ska-sa/roach2_chassis_design/Notes/ROACH 2 Thermal Analaysis/ROACH 2 Chassis Thermal Report Idle/ROACH_2_Idle_10k.bmp

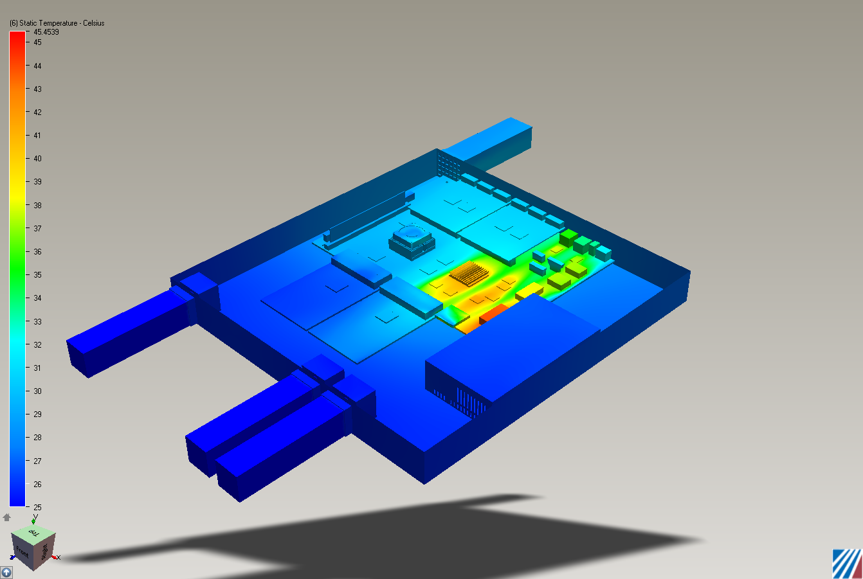
Notes/ROACH 2 Thermal Analaysis/ROACH 2 Chassis Thermal Report Idle/ROACH_2_Idle_10k.bmp
