ska-sa/roach2_chassis_design/Pro-Engineer_Files/ROACH_2_Chassis_SMA/roach_2_assembly.jpg

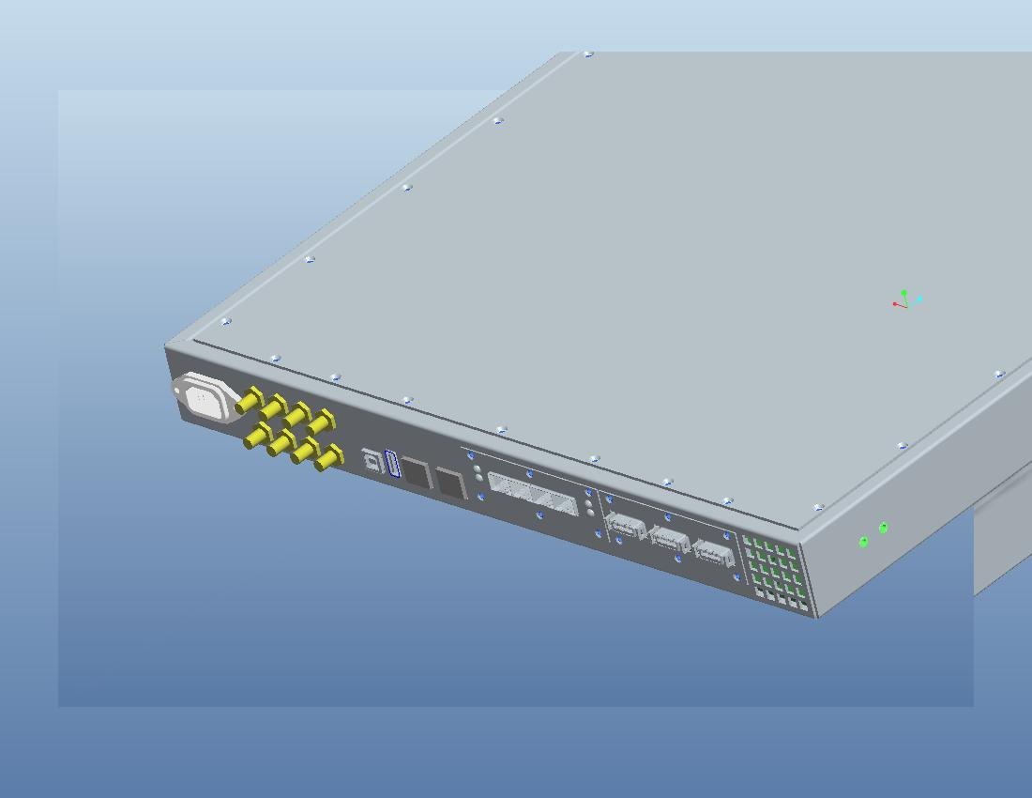
Pro-Engineer_Files/ROACH_2_Chassis_SMA/roach_2_assembly.jpg
