ska-sa/roach2_chassis_design/README.txt

Files in this repo:
CFD_Models - simplified 3d CAD files for thermal analaysis
Notes - documentation requested at various times
Pro-Engineeer_Files - 3d CAD files used in Pro-Engineer/Creo
roach_2_manufacture - 3d CAD (in .stp), pdf etc required for manufacturing the chassis
