ska-sa/roach2_chassis_design/Notes/ROACH 2 Thermal Analaysis/ROACH 2 Chassis Thermal Report Normal Run/FPGA_20W.bmp

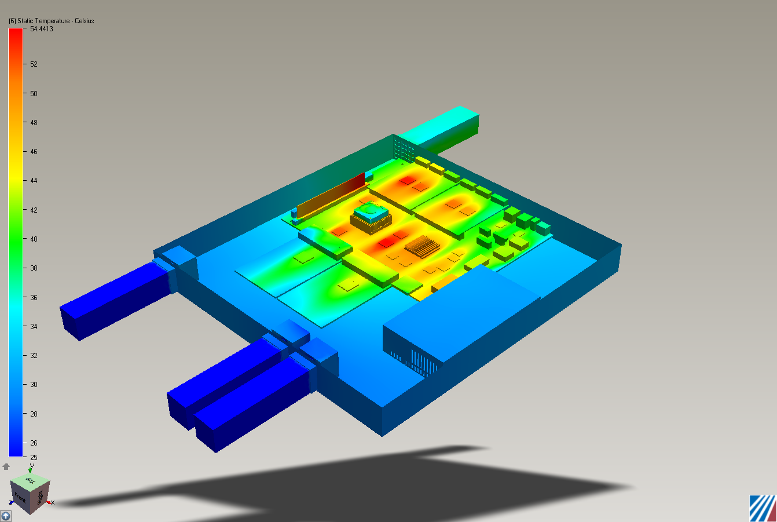
Notes/ROACH 2 Thermal Analaysis/ROACH 2 Chassis Thermal Report Normal Run/FPGA_20W.bmp
