ska-sa/roach2_chassis_design/Pro-Engineer_Files/kat_adc_2012/adc1x2200-10_v1-1.jpg

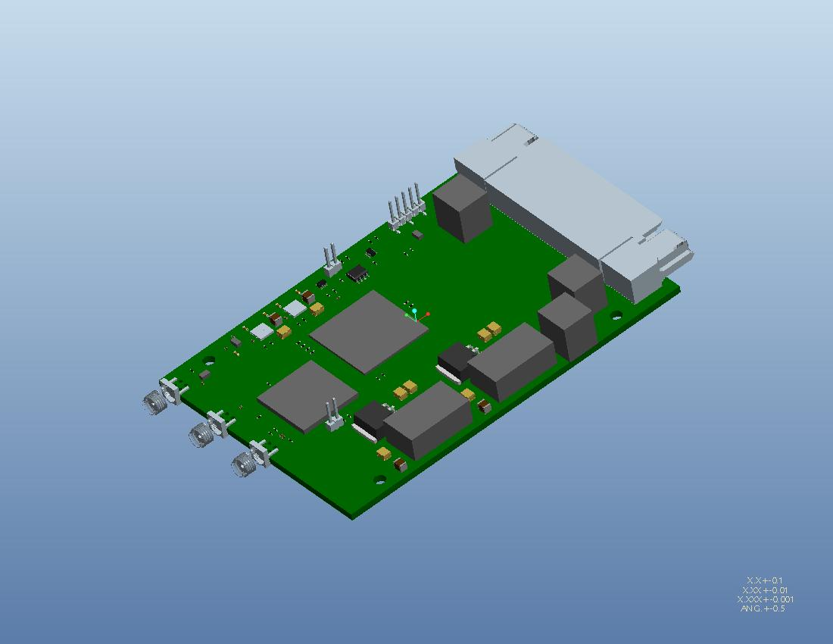
Pro-Engineer_Files/kat_adc_2012/adc1x2200-10_v1-1.jpg
