ska-sa/roach2_chassis_design/Pro-Engineer_Files/ROACH_2_Chassis/roach_2_chassis_iso.tif

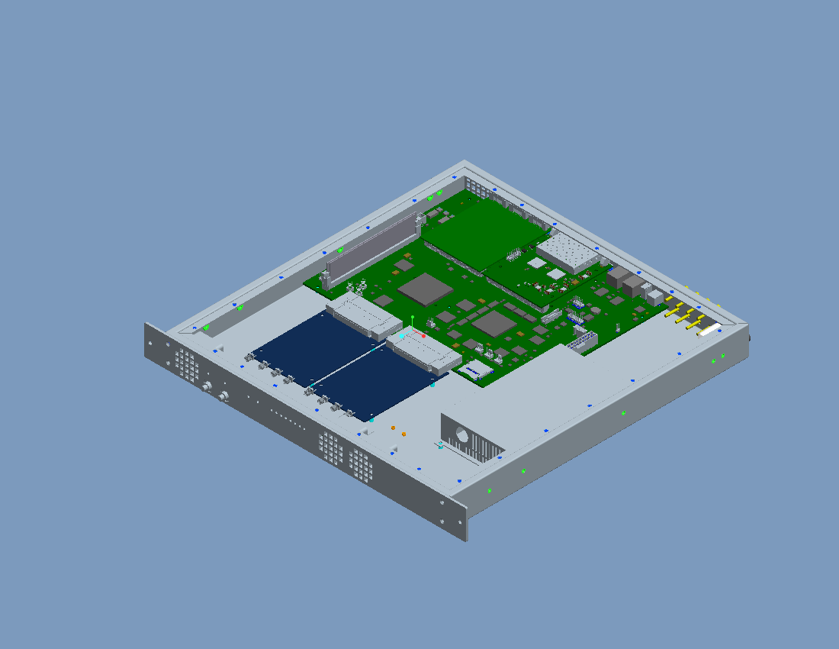
Pro-Engineer_Files/ROACH_2_Chassis/roach_2_chassis_iso.tif
