ska-sa/roach2_chassis_design/Thermal_Pics/DC_0255.jpg

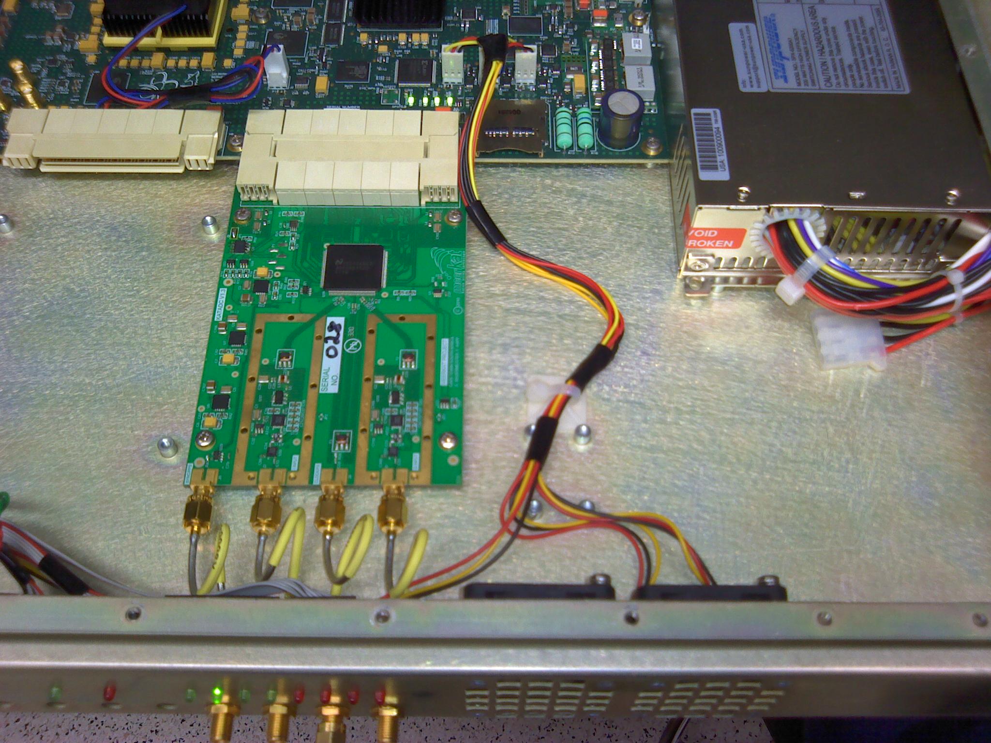
Thermal_Pics/DC_0255.jpg
