ska-sa/roach2_chassis_design/Thermal_Pics/DC_0261.jpg

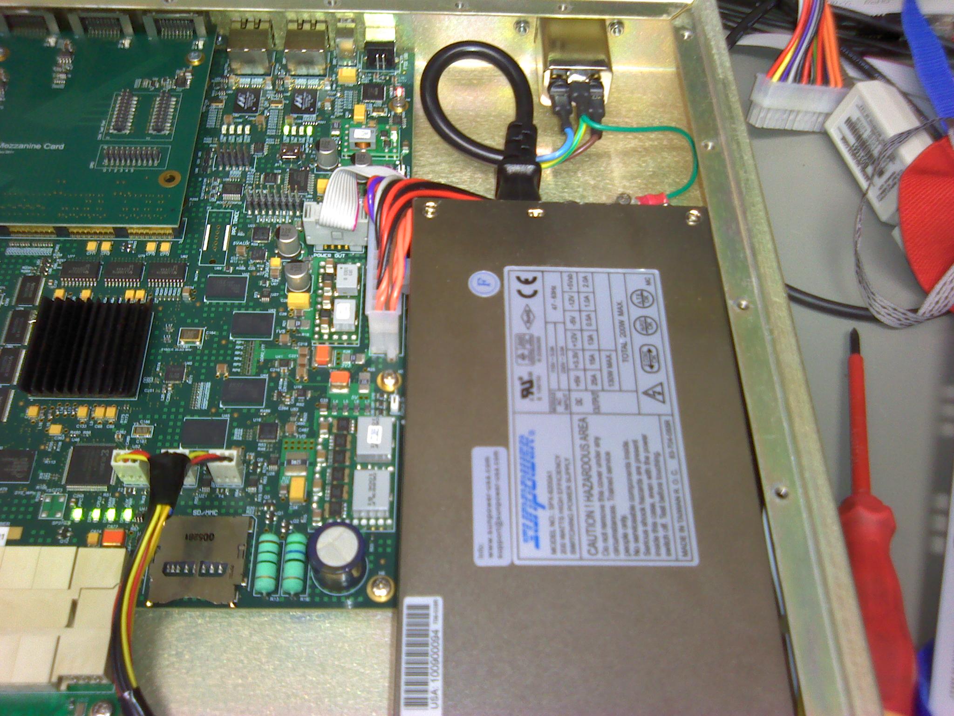
Thermal_Pics/DC_0261.jpg
