ska-sa/roach2_chassis_design/Thermal_Pics/DC_0293.jpg

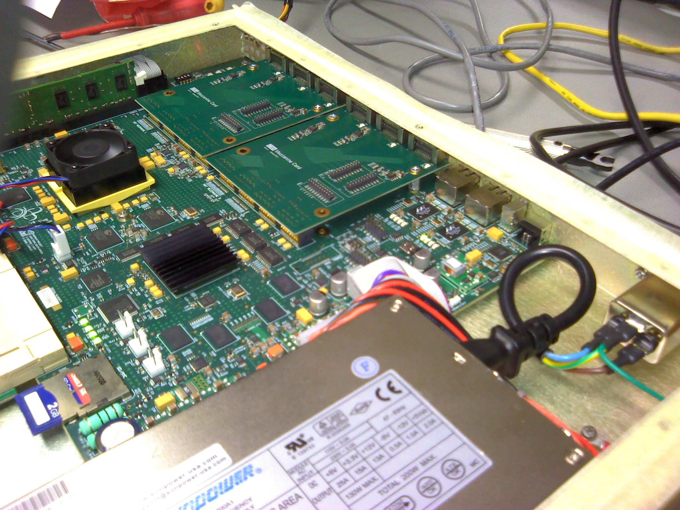
Thermal_Pics/DC_0293.jpg
