ska-sa/roach2_chassis_design/Thermal_Pics/IR_0256.jpg

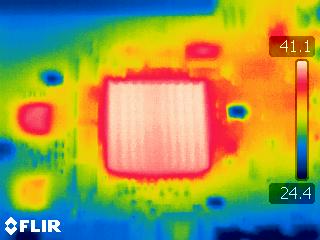
Thermal_Pics/IR_0256.jpg
