ska-sa/roach2_chassis_design/Thermal_Pics/IR_0260.jpg

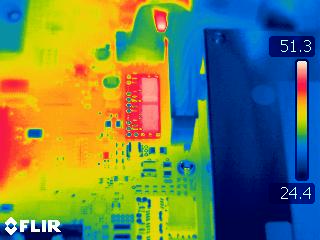
Thermal_Pics/IR_0260.jpg
