ska-sa/roach2_chassis_design/Thermal_Pics/IR_0272.jpg

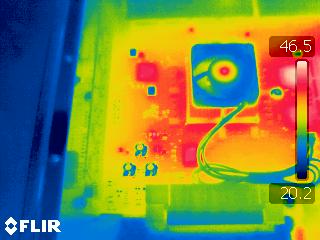
Thermal_Pics/IR_0272.jpg
