ska-sa/roach2_chassis_design/Thermal_Pics/IR_0278.jpg

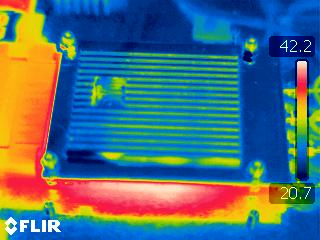
Thermal_Pics/IR_0278.jpg
