ska-sa/roach2_chassis_design/CFD_Models/ROACH_2_CFD_5.2_AllFab_L_Out/adc_new/new_adc.stp

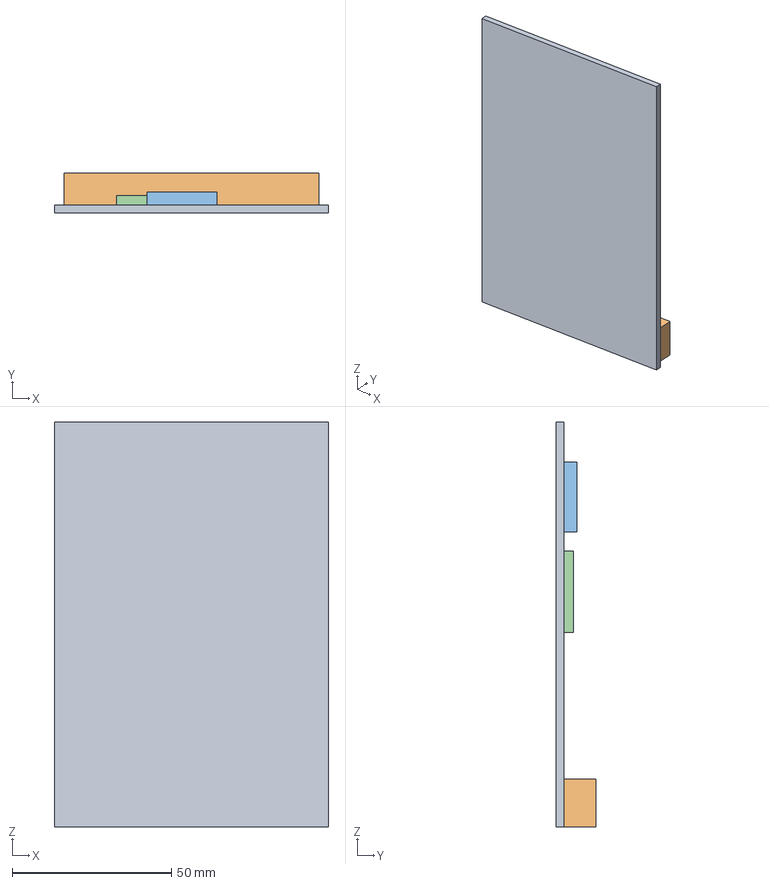
[picture p56: CAD file, 2013-02-20]
CFD_Models/ROACH_2_CFD_5.2_AllFab_L_Out/adc_new/new_adc.stp
86.0 x 12.5 x 127.0 mm
ADC_PCB
ADC_CONNECTOR
ADC_CHIP_NEW
DMUX
