ska-sa/roach2_chassis_design/Pro-Engineer_Files/Current_ROACH_2_Chassis/roach-2-chassis-back.dxf

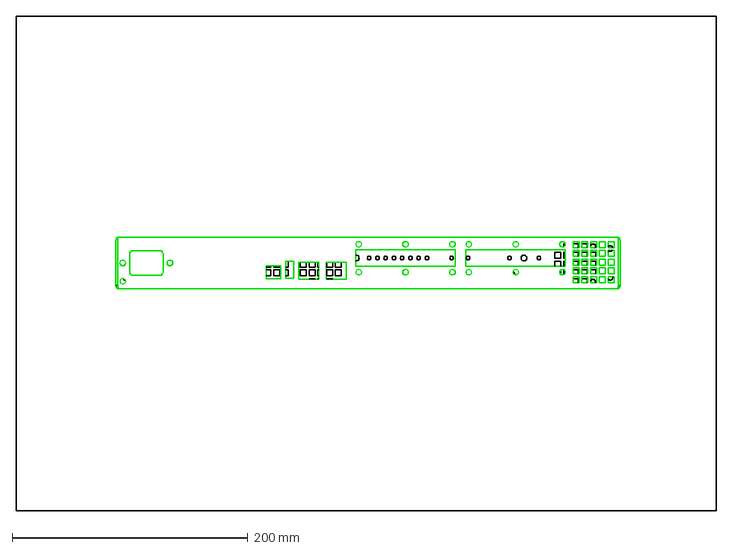
[picture p57: CAD file, 2014-04-12]
Pro-Engineer_Files/Current_ROACH_2_Chassis/roach-2-chassis-back.dxf
594.0 x 420.0 mm
