ska-sa/roach2_chassis_design/Pro-Engineer_Files/ROACH_2_Chassis/ROACH_PCB/User Library-ddr3 dimm sdram.STEP

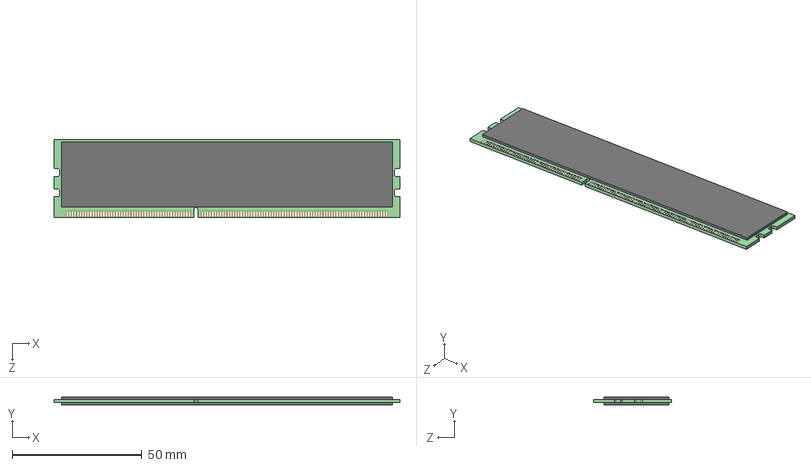
[picture p58: CAD file, 2013-05-10]
Pro-Engineer_Files/ROACH_2_Chassis/ROACH_PCB/User Library-ddr3 dimm sdram.STEP
133.3 x 3.27 x 30.0 mm
