ska-sa/roach2_chassis_design/Pro-Engineer_Files/ROACH_2_Chassis_SMA/roach-2-chassis-manufacturer_bpanel.dxf

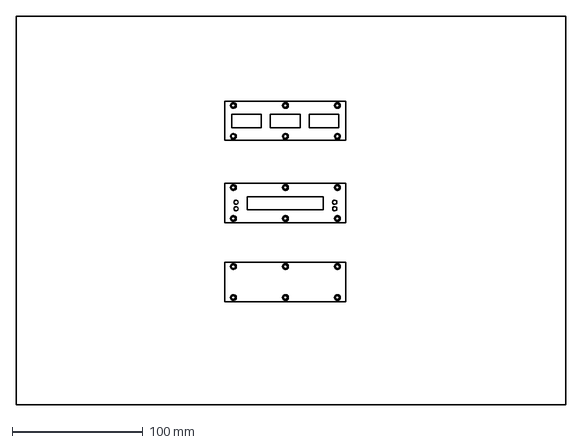
[picture p60: CAD file, 2012-06-26]
Pro-Engineer_Files/ROACH_2_Chassis_SMA/roach-2-chassis-manufacturer_bpanel.dxf
420.0 x 297.0 mm
