ska-sa/roach2_chassis_design/roach_2_manufacture/dxf/roach-2-chassis-flat.dxf

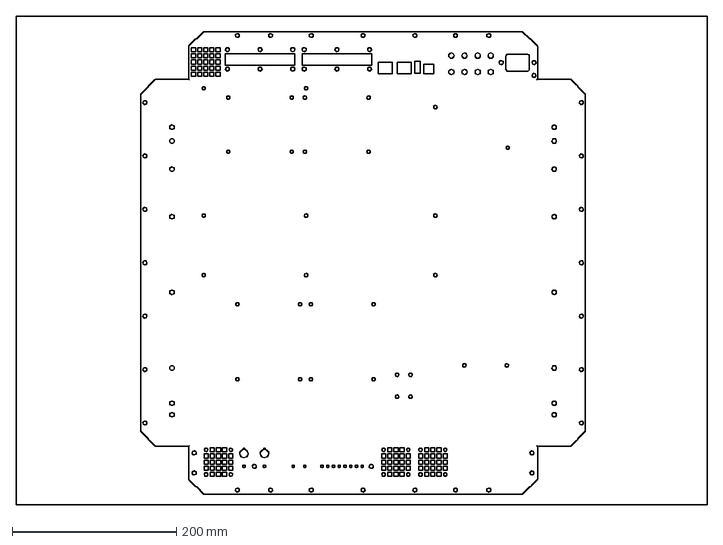
[picture p61: CAD file, 2014-04-24]
roach_2_manufacture/dxf/roach-2-chassis-flat.dxf
841.0 x 594.0 mm
