ska-sa/roach2_chassis_design/roach_2_manufacture/stp_files/roach-2-chassis.stp

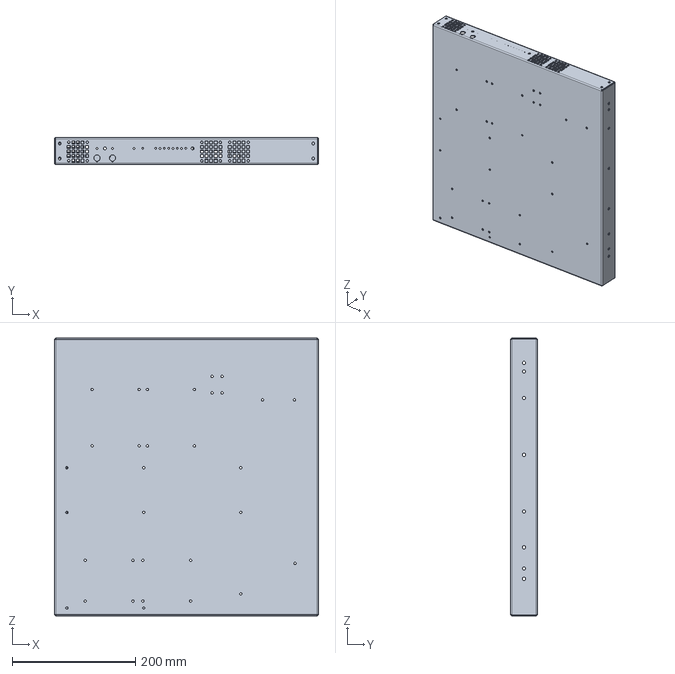
[picture p62: CAD file, 2014-04-24]
roach_2_manufacture/stp_files/roach-2-chassis.stp
428.0 x 43.7 x 450.0 mm
