ska-sa/roach2_chassis_design/Pro-Engineer_Files/Current_ROACH_2_Chassis/keystone-PN615.STEP

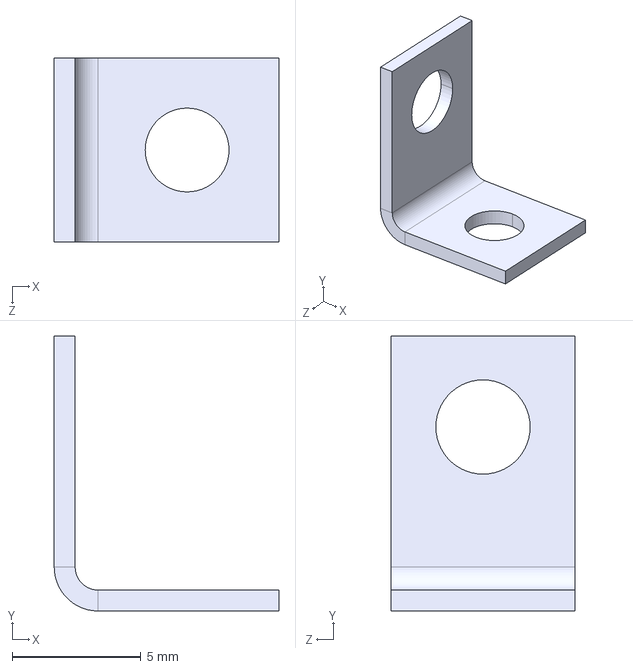
[picture p63: CAD file, 2014-04-12]
Pro-Engineer_Files/Current_ROACH_2_Chassis/keystone-PN615.STEP
8.71 x 10.7 x 7.14 mm
