ska-sa/roach2_chassis_design/Pro-Engineer_Files/ROACH_2_Chassis_SMA/roach-2-chassis-manufacturer_bck.dxf

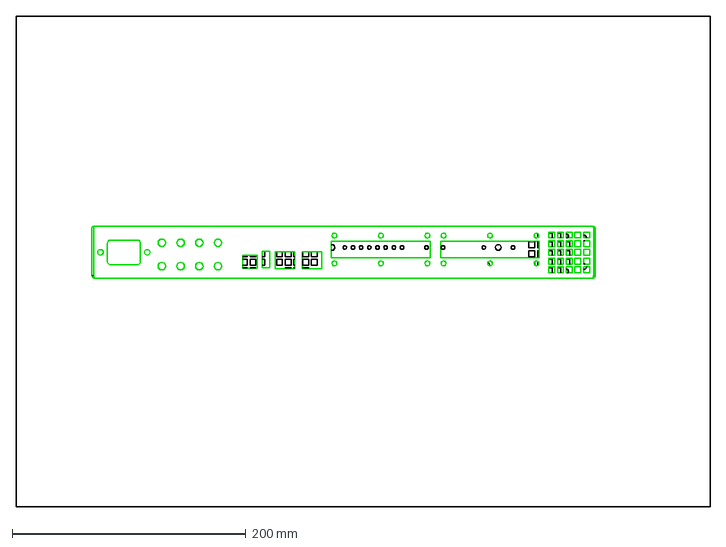
[picture p65: CAD file, 2012-06-26]
Pro-Engineer_Files/ROACH_2_Chassis_SMA/roach-2-chassis-manufacturer_bck.dxf
594.0 x 420.0 mm
