ska-sa/roach2_chassis_design/roach_2_manufacture/dxf/roach-2-chassis-back-panels.dxf

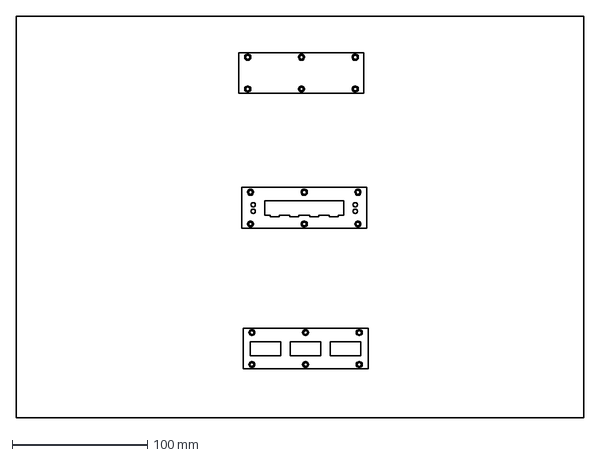
[picture p66: CAD file, 2013-12-18]
roach_2_manufacture/dxf/roach-2-chassis-back-panels.dxf
420.0 x 297.0 mm
