ska-sa/roach2_chassis_design/roach_2_manufacture/stp_files/back_panel_sfp.stp

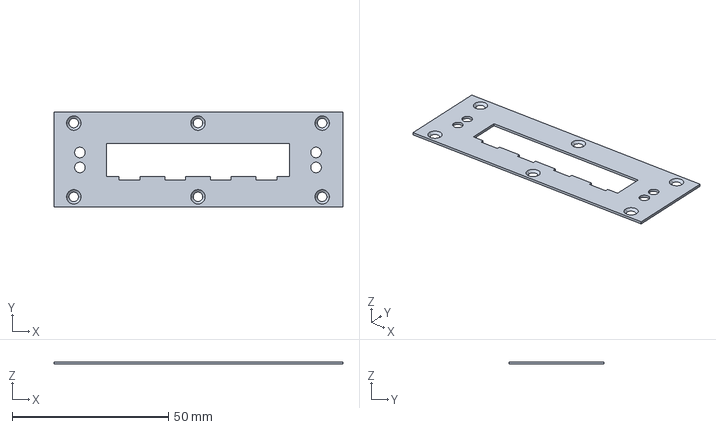
[picture p67: CAD file, 2013-12-18]
roach_2_manufacture/stp_files/back_panel_sfp.stp
92.5 x 30.5 x 0.8 mm
