ska-sa/roach2_chassis_design/Pro-Engineer_Files/ROACH_2_Chassis_SMA/roach-2-chassis.dxf

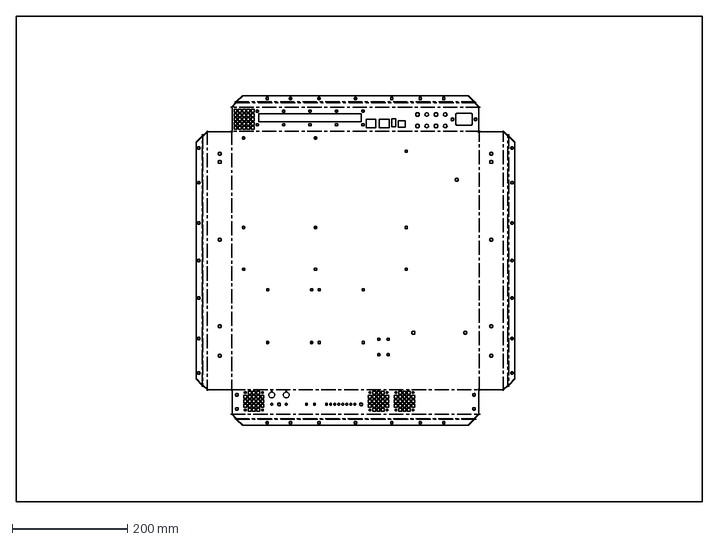
[picture p69: CAD file, 2012-05-10]
Pro-Engineer_Files/ROACH_2_Chassis_SMA/roach-2-chassis.dxf
1189.0 x 841.0 mm
