ska-sa/roach2_chassis_design/roach_2_manufacture/dxf/roach-2-chassis-lid.dxf

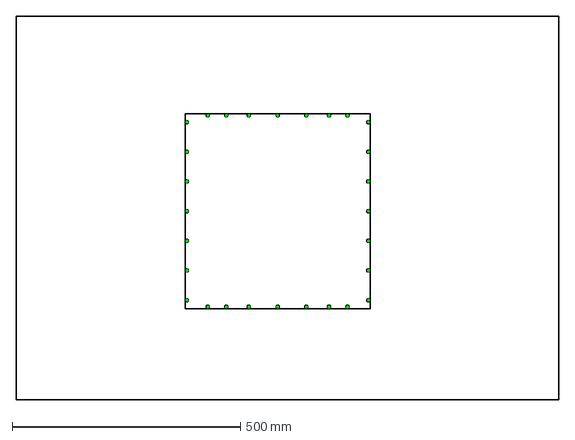
[picture p70: CAD file, 2013-11-07]
roach_2_manufacture/dxf/roach-2-chassis-lid.dxf
1189.0 x 841.0 mm
