ska-sa/roach2_chassis_design/roach_2_manufacture/stp_files/tc-1u20fx2_bracket.stp

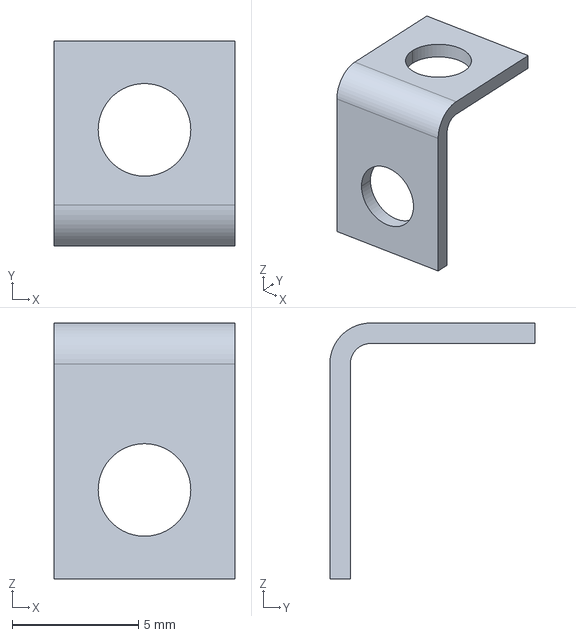
[picture p71: CAD file, 2013-11-07]
roach_2_manufacture/stp_files/tc-1u20fx2_bracket.stp
7.14 x 8.12 x 10.1 mm
