ska-sa/roach2_chassis_design/Pro-Engineer_Files/ROACH_2_Chassis_SMA/AllFab_Step_Files/front_panel.stp

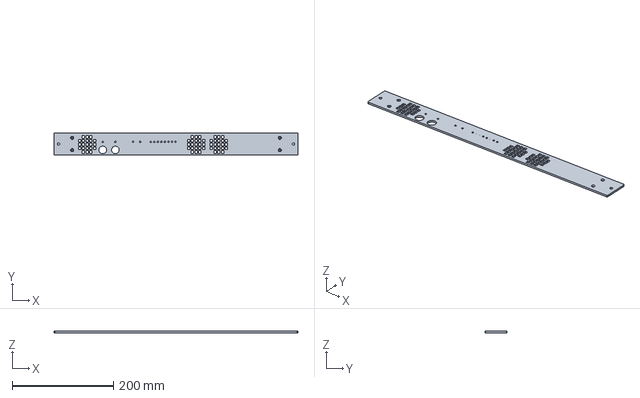
[picture p72: CAD file, 2013-05-10]
Pro-Engineer_Files/ROACH_2_Chassis_SMA/AllFab_Step_Files/front_panel.stp
483.0 x 44.5 x 3.00 mm
