ska-sa/roach2_chassis_design/roach_2_manufacture/stp_files/back_panel_cx4.stp

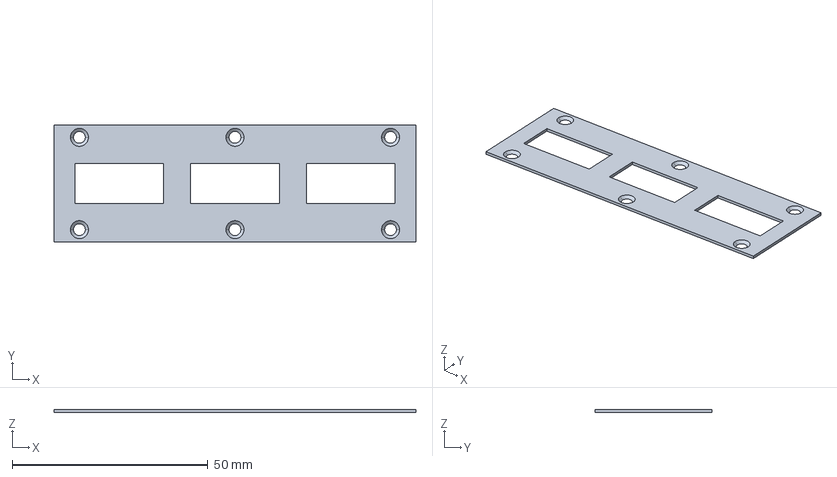
[picture p75: CAD file, 2013-11-07]
roach_2_manufacture/stp_files/back_panel_cx4.stp
92.5 x 30.0 x 0.8 mm
