ska-sa/roach2_chassis_design/Pro-Engineer_Files/ROACH_2_Chassis_SMA/ROACH-2-LID.dxf

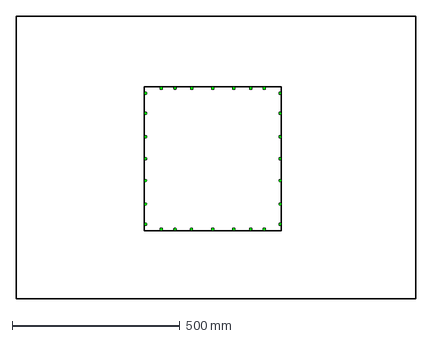
[picture p76: CAD file, 2012-05-10]
Pro-Engineer_Files/ROACH_2_Chassis_SMA/ROACH-2-LID.dxf
1189.0 x 841.0 mm
