ska-sa/roach2_chassis_design/Pro-Engineer_Files/ROACH_2_Chassis_SMA/AllFab_Step_Files/back_panel_blank.stp

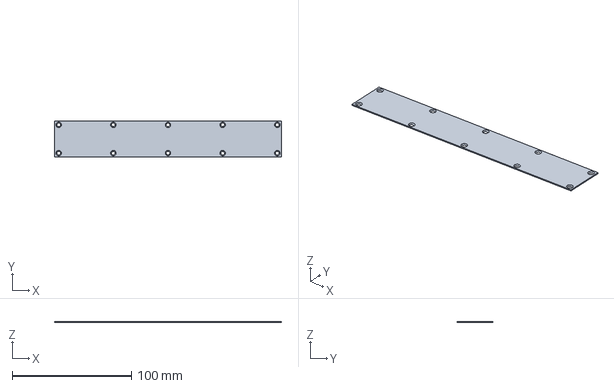
[picture p77: CAD file, 2013-05-10]
Pro-Engineer_Files/ROACH_2_Chassis_SMA/AllFab_Step_Files/back_panel_blank.stp
190.0 x 30.0 x 0.8 mm
