ska-sa/roach2_chassis_design/Pro-Engineer_Files/ROACH_2_Chassis_SMA/roach-2-back-panels.dxf

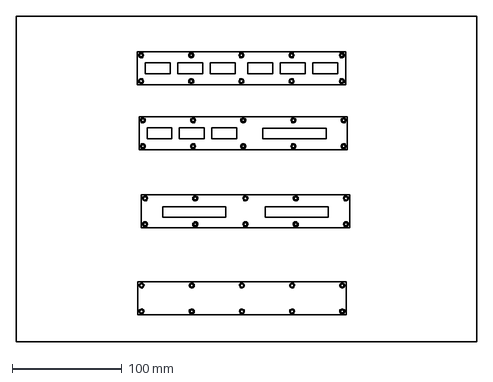
[picture p78: CAD file, 2012-05-10]
Pro-Engineer_Files/ROACH_2_Chassis_SMA/roach-2-back-panels.dxf
420.0 x 297.0 mm
