ska-sa/roach2_chassis_design/roach_2_manufacture/stp_files/roach_2_lid.stp

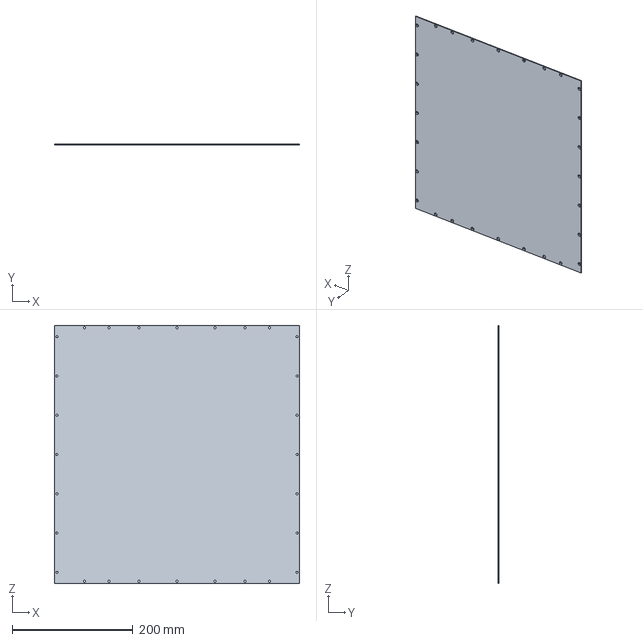
[picture p79: CAD file, 2013-11-07]
roach_2_manufacture/stp_files/roach_2_lid.stp
405.5 x 1.60 x 427.5 mm
