ska-sa/roach2_chassis_design/roach_2_manufacture/stp_files/back_panel_blank.stp

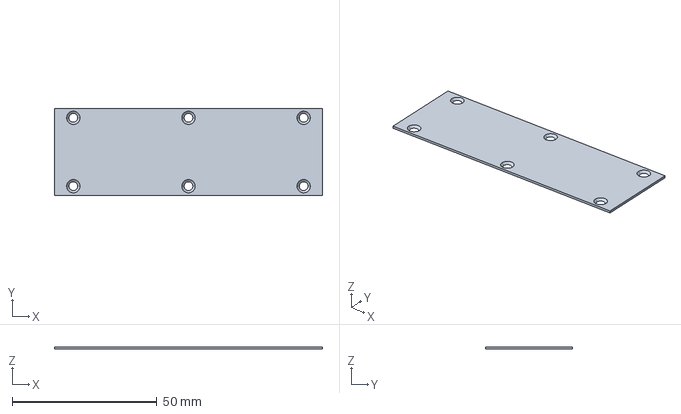
[picture p80: CAD file, 2012-06-26]
roach_2_manufacture/stp_files/back_panel_blank.stp
92.5 x 30.0 x 0.8 mm
