ska-sa/roach2_chassis_design/(list of files, cad)

Other CAD files:
Pro-Engineer_Files/ROACH_2_Chassis_SMA/AllFab_Step_Files/roach_2_chassis_sheet_rev_2.stp
roach_2_manufacture/stp_files/front_panel.stp
Pro-Engineer_Files/ROACH_2_Chassis_SMA/AllFab_Step_Files/roach_2_lid.stp
roach_2_manufacture/stp_files/ront_panel.stp
