ska-sa/roach2_chassis_design/roach_2_manufacture/documentation/roach-2-chassis-back-panels.pdf

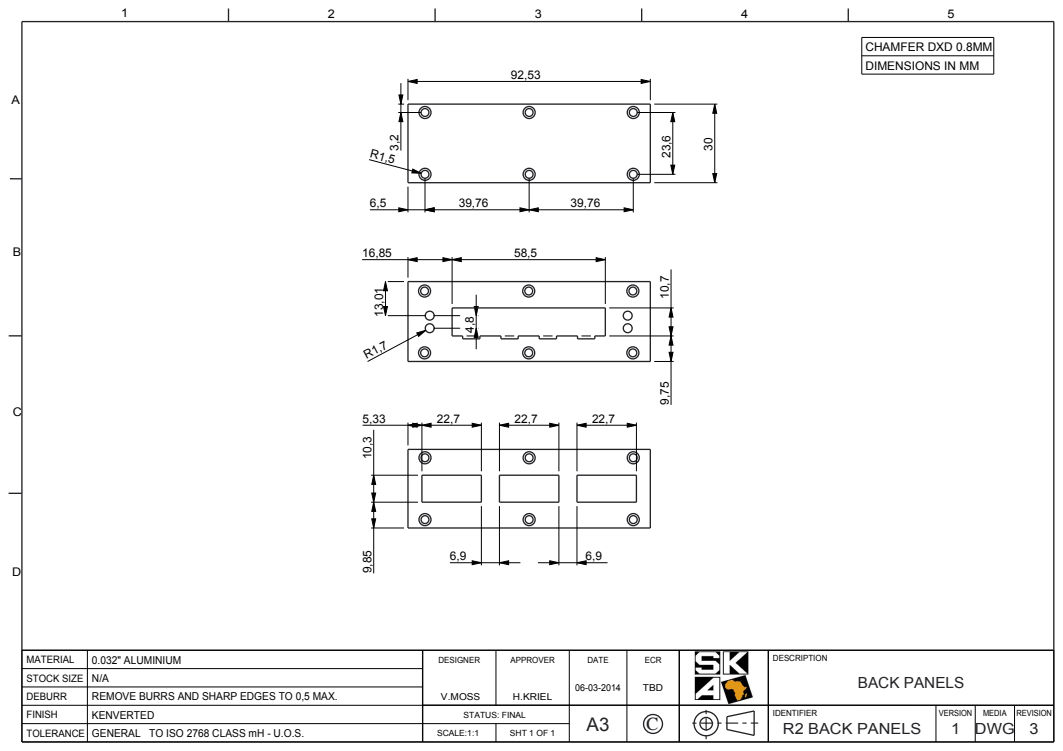
[picture p81: page 1]
TOLERANCE; GENERAL TO ISO 2768 CLASS mH - U.O.S.; SCALE:1:1; SHT 1 OF 1; R2 BACK PANELS; DWG

CHAMFER DXD 0.8MM
DIMENSIONS IN MM

MATERIAL | 0.032" ALUMINIUM | DESIGNER V.MOSS | APPROVER H.KRIEL | DATE 06-03-2014 | ECR TBD | DESCRIPTION BACK PANELS STOCK SIZE
N/A
DEBURR | REMOVE BURRS AND SHARP EDGES TO 0,5 MAX.
FINISH | KENVERTED | STATUS: FINAL | | C | | | IDENTIFIER | VERSION | MEDIA | REVISION
