ska-sa/roach2_chassis_design/roach_2_manufacture/documentation/roach-2-chassis-general.pdf

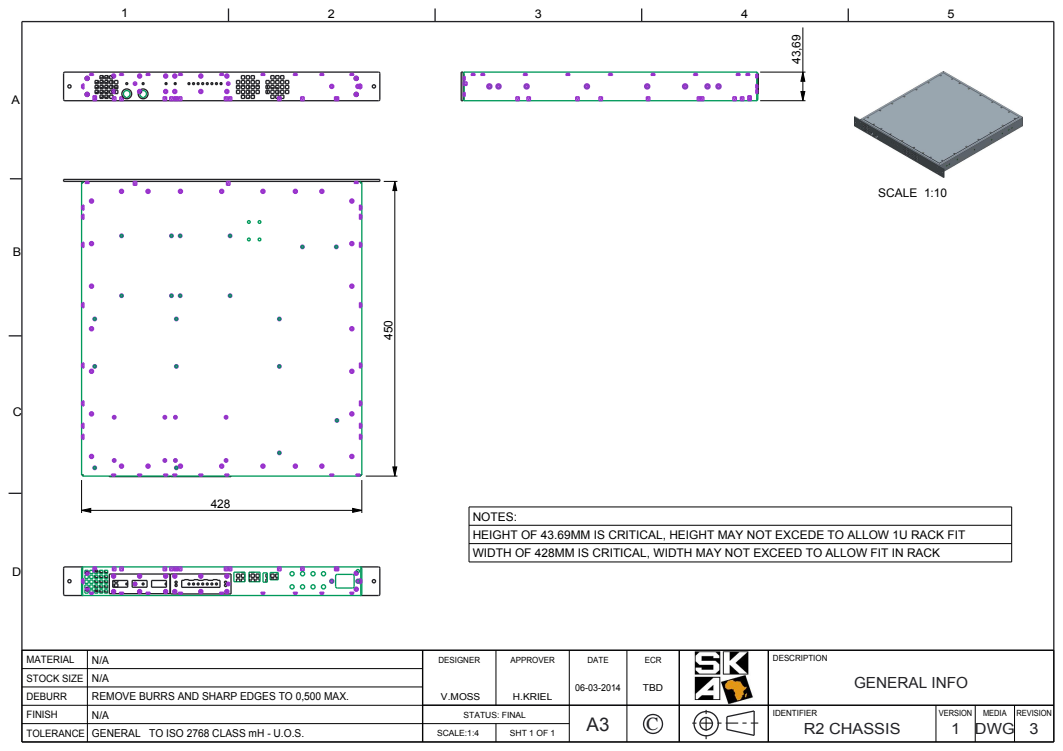
[picture p82: page 1]
TOLERANCE; GENERAL TO ISO 2768 CLASS mH - U.O.S.; SCALE:1:4; SHT 1 OF 1; R2 CHASSIS; DWG; SCALE 1:10

NOTES:
HEIGHT OF 43.69MM IS CRITICAL, HEIGHT MAY NOT EXCEDE TO ALLOW 1U RACK FIT
WIDTH OF 428MM IS CRITICAL, WIDTH MAY NOT EXCEED TO ALLOW FIT IN RACK

MATERIAL | N/A | DESIGNER V.MOSS | APPROVER H.KRIEL | DATE 06-03-2014 | ECR TBD | DESCRIPTION GENERAL INFO STOCK SIZE
N/A
DEBURR | REMOVE BURRS AND SHARP EDGES TO 0,500 MAX.
FINISH | N/A | STATUS: FINAL | | C | | | IDENTIFIER | VERSION | MEDIA | REVISION
