ska-sa/roach2_chassis_design/roach_2_manufacture/documentation/roach-2-chassis-info.pdf

5,085,08

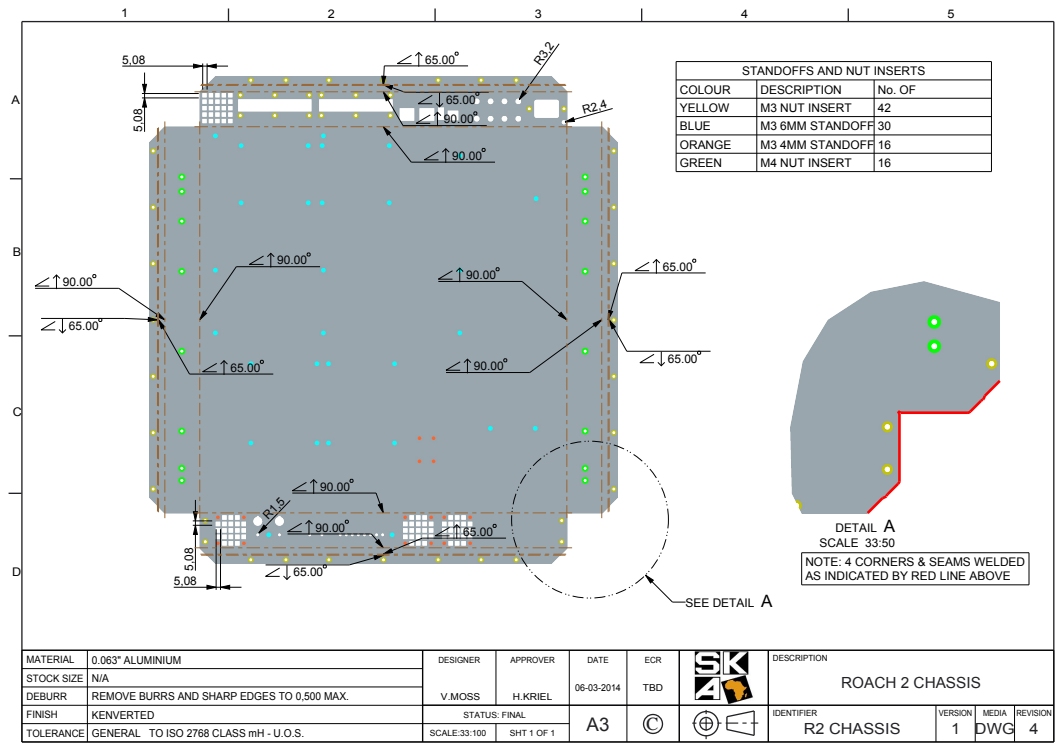
[picture p83: page 1]
TOLERANCE; GENERAL TO ISO 2768 CLASS mH - U.O.S.; SCALE:33:100; SHT 1 OF 1; R2 CHASSIS; DWG; SEE DETAIL A

STANDOFFS AND NUT INSERTS

COLOUR | DESCRIPTION | No. OF
YELLOW | M3 NUT INSERT | 42
BLUE | M3 6MM STANDOFF 30
ORANGE | M3 4MM STANDOFF 16
GREEN | M4 NUT INSERT | 16

DETAIL A
SCALE 33:50
NOTE: 4 CORNERS & SEAMS WELDED
AS INDICATED BY RED LINE ABOVE

MATERIAL | 0.063" ALUMINIUM | DESIGNER V.MOSS | APPROVER H.KRIEL | DATE 06-03-2014 | ECR TBD | DESCRIPTION ROACH 2 CHASSIS STOCK SIZE
N/A
DEBURR | REMOVE BURRS AND SHARP EDGES TO 0,500 MAX.
FINISH | KENVERTED | STATUS: FINAL | | C | | | IDENTIFIER | VERSION | MEDIA | REVISION
