ska-sa/roach2_chassis_design/roach_2_manufacture/documentation/tc-1u20fx2_bracket.pdf

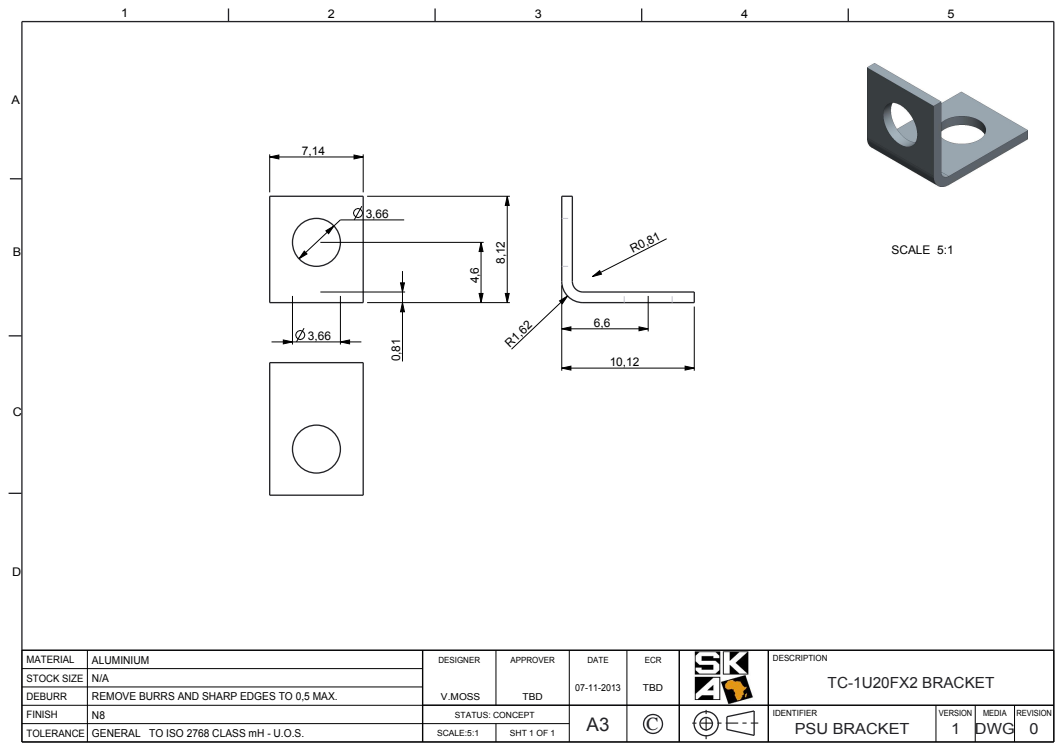
[picture p84: page 1]
TOLERANCE; GENERAL TO ISO 2768 CLASS mH - U.O.S.; SCALE:5:1; SHT 1 OF 1; PSU BRACKET; DWG; SCALE 5:1

MATERIAL | ALUMINIUM | DESIGNER V.MOSS | APPROVER TBD | DATE 07-11-2013 | ECR TBD | DESCRIPTION TC-1U20FX2 BRACKET STOCK SIZE
N/A
DEBURR | REMOVE BURRS AND SHARP EDGES TO 0,5 MAX.
FINISH | N8 | STATUS: CONCEPT | | C | | | IDENTIFIER | VERSION | MEDIA | REVISION
