ska-sa/roach2_chassis_design/roach_2_manufacture/silkscreens/back.pdf

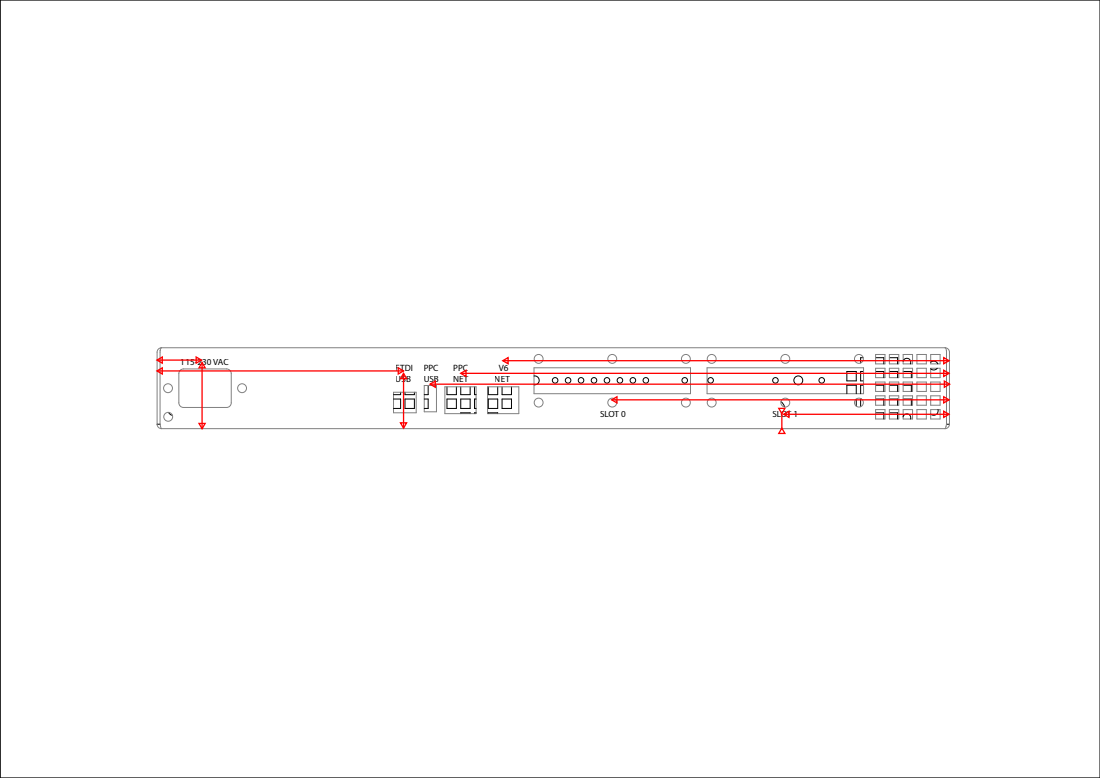
[picture p85: page 1]
SLOT 0; SLOT 1; FTDI USB; PPC USB; PPC NET; V6 NET; 115-230 VAC

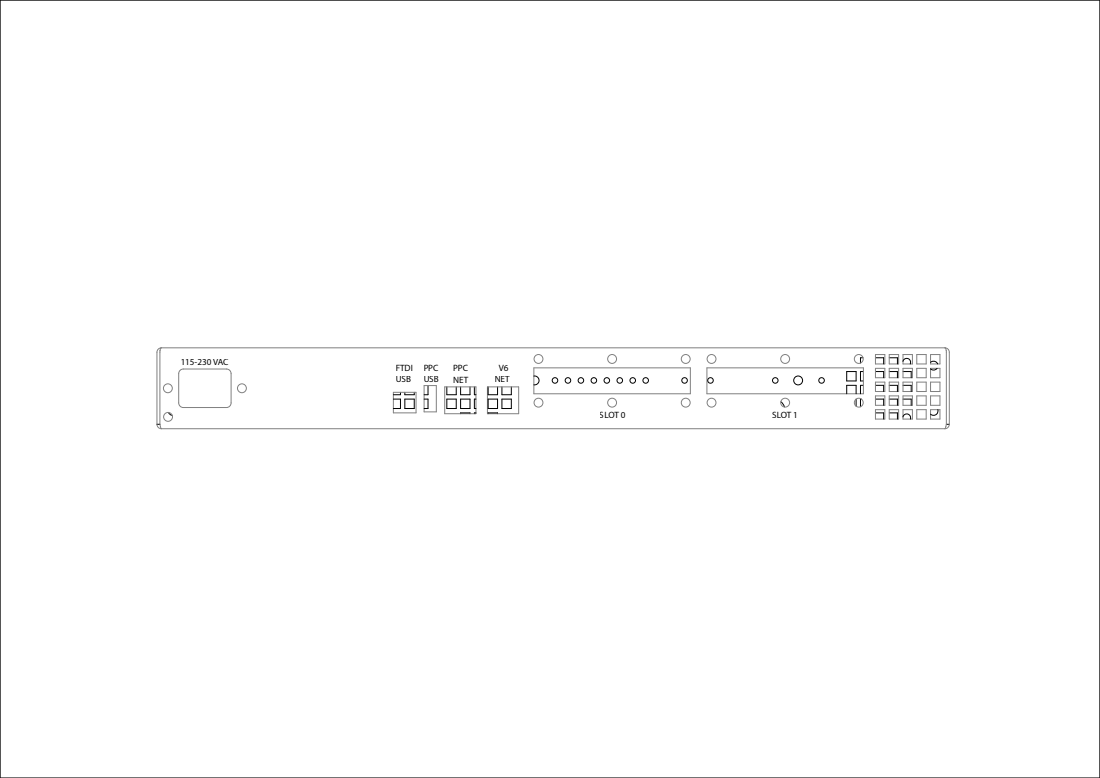
[picture p86: page 2]
SLOT 0; SLOT 1; FTDI USB; PPC USB; PPC NET; V6 NET; 115-230 VAC
