ska-sa/roach2_chassis_design/roach_2_manufacture/silkscreens/front_panel.pdf

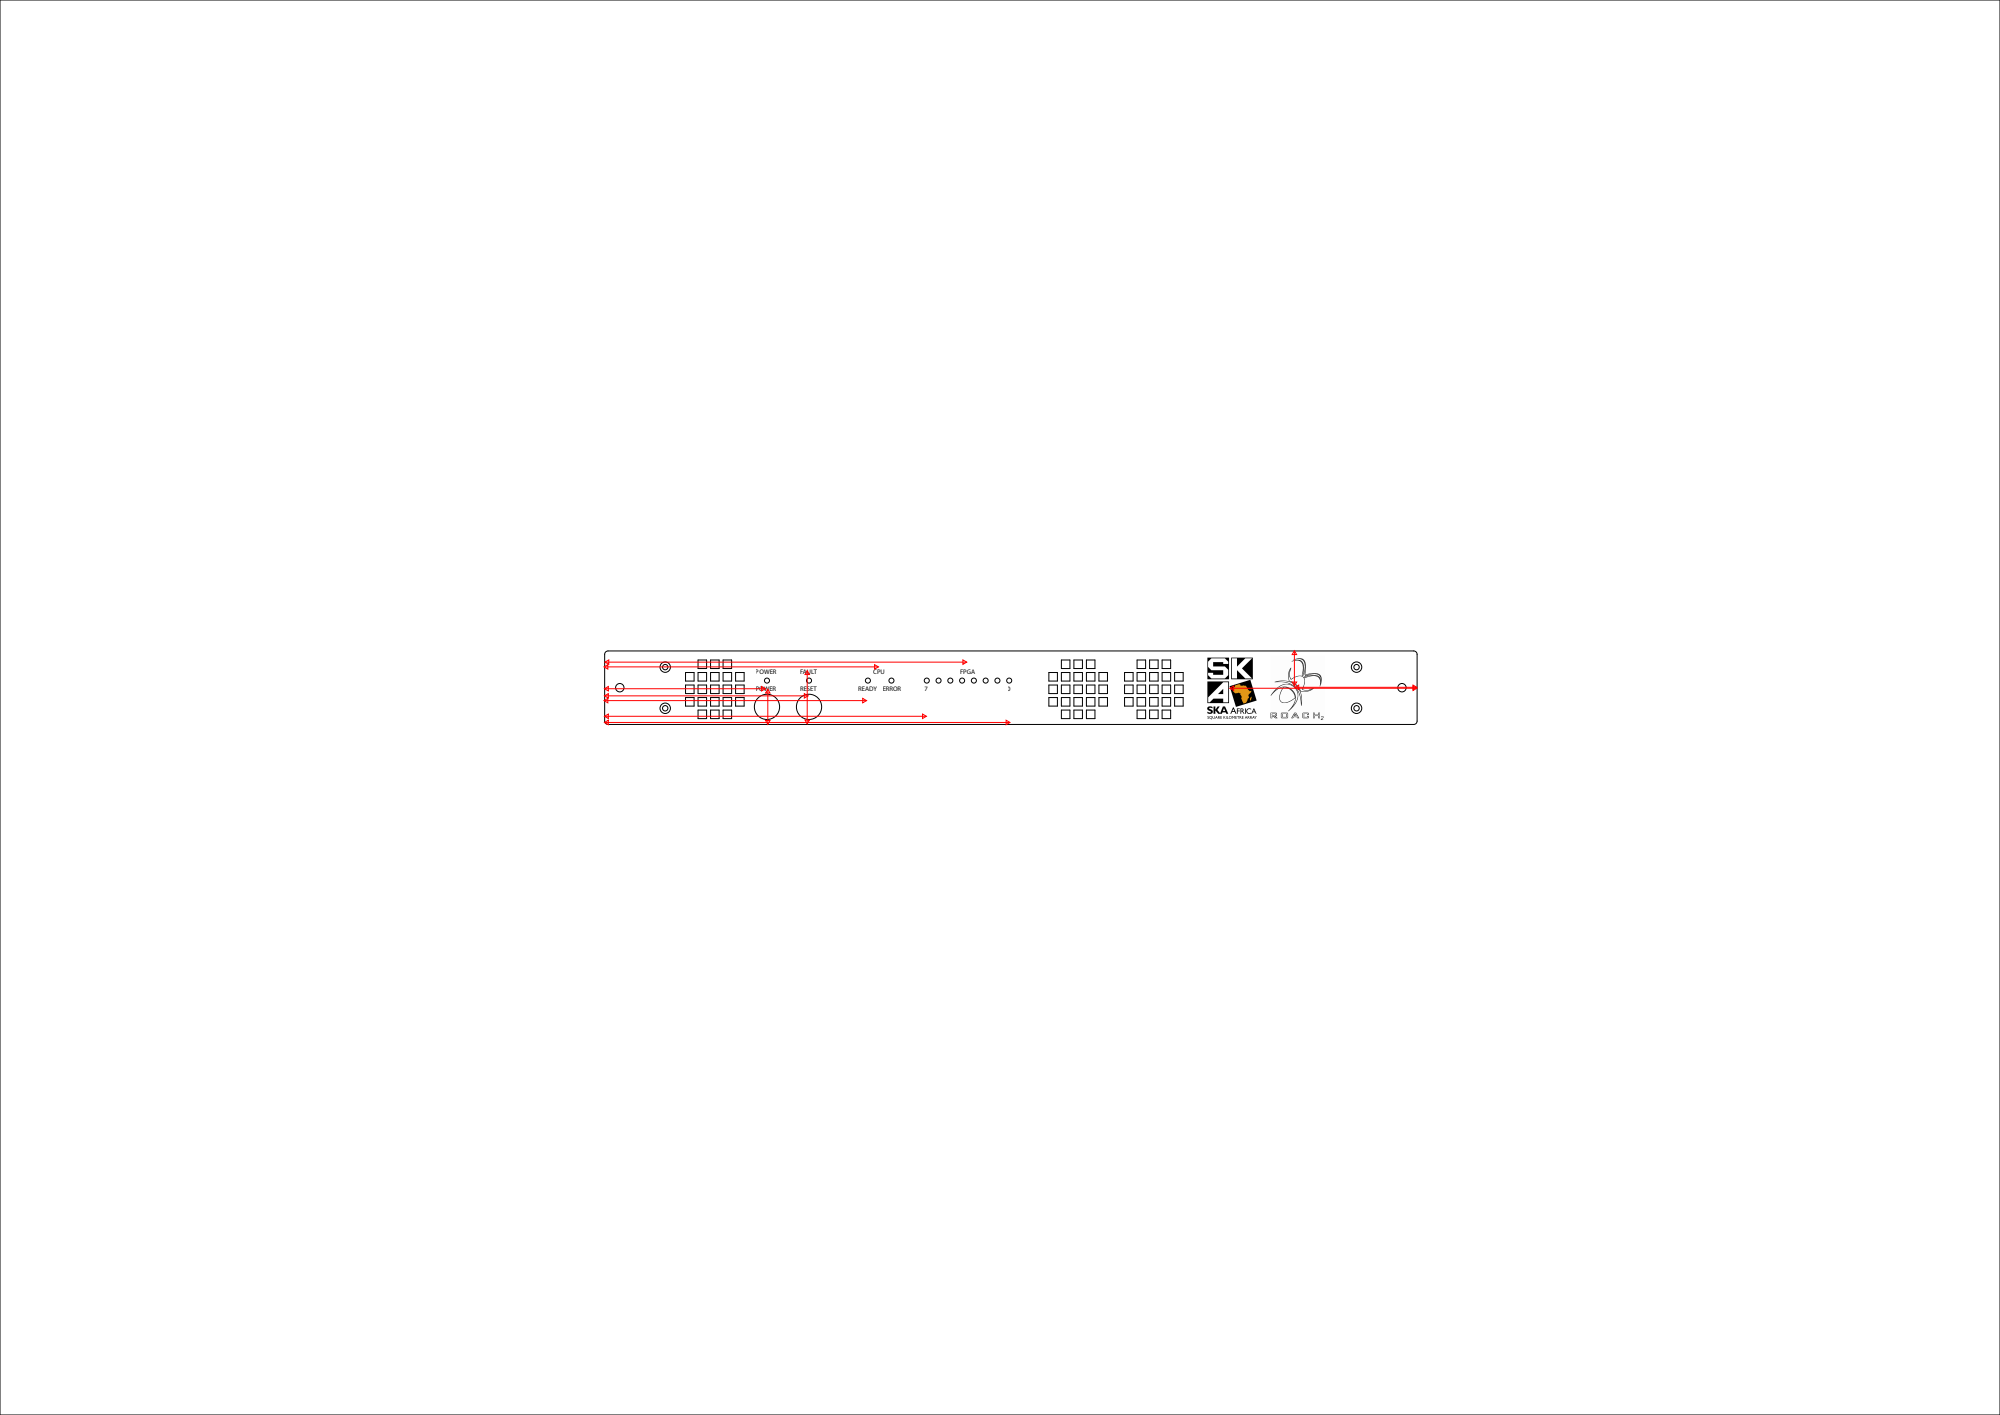
[picture p87: page 1]
POWER; FAULT; CPU; FPGA; RESET; READY ERROR
