ska-sa/roach2_chassis_design/roach_2_manufacture/supporting_documentation/SKA002_A1.pdf

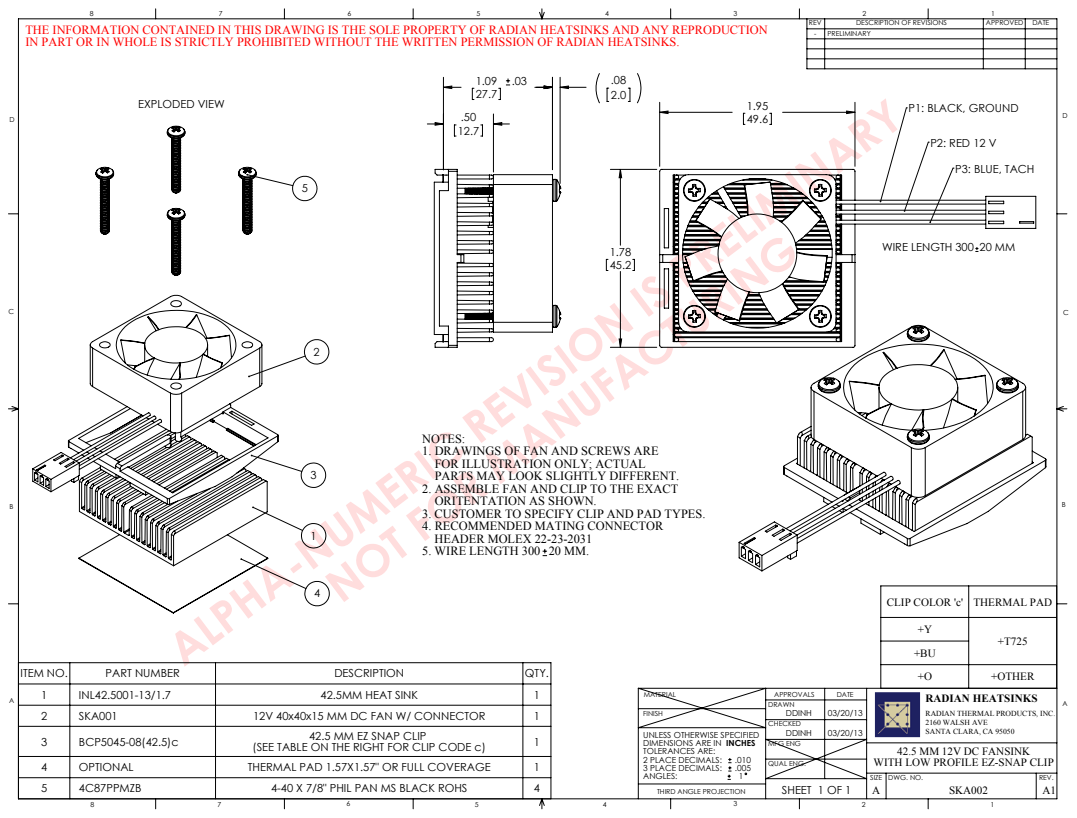
[picture p88: page 1]
P1: BLACK, GROUND; P2: RED 12 V; P3: BLUE, TACH; ITEM NO.; PART NUMBER; DESCRIPTION; QTY.; SIZE DWG. NO.; REV.; SHEET 1 OF 1; MFG ENG; QUAL ENG.; - PRELIMINARY; REV; APPROVED DATE

THE INFORMATION CONTAINED IN THIS DRAWING IS THE SOLE PROPERTY OF RADIAN HEATSINKS AND ANY REPRODUCTION
IN PART OR IN WHOLE IS STRICTLY PROHIBITED WITHOUT THE WRITTEN PERMISSION OF RADIAN HEATSINKS.

DESCRIPTION OF REVISIONS

ALPHA-NUMERIC REVISION IS PRELIMINARY NOT FOR MANUFACTURING
EXPLODED VIEW

WIRE LENGTH 300 20 MM

NOTES:
1. DRAWINGS OF FAN AND SCREWS ARE
FOR ILLUSTRATION ONLY; ACTUAL
PARTS MAY LOOK SLIGHTLY DIFFERENT.
2. ASSEMBLE FAN AND CLIP TO THE EXACT
ORITENTATION AS SHOWN.
3. CUSTOMER TO SPECIFY CLIP AND PAD TYPES.
4. RECOMMENDED MATING CONNECTOR
HEADER MOLEX 22-23-2031
5. WIRE LENGTH 300 20 MM.

CLIP COLOR 'c' | THERMAL PAD
+Y | +T725

RADIAN HEATSINKS
RADIAN THERMAL PRODUCTS, INC.
2160 WALSH AVE
SANTA CLARA, CA 95050
42.5 MM 12V DC FANSINK
WITH LOW PROFILE EZ-SNAP CLIP

1 | INL42.5001-13/1.7 | 42.5MM HEAT SINK | 1
2 | SKA001 | 12V 40x40x15 MM DC FAN W/ CONNECTOR | 1
3 | BCP5045-08(42.5)c | 42.5 MM EZ SNAP CLIP (SEE TABLE ON THE RIGHT FOR CLIP CODE c) | 1

FINISH
UNLESS OTHERWISE SPECIFIED
DIMENSIONS ARE IN INCHES
TOLERANCES ARE:
2 PLACE DECIMALS: .010
3 PLACE DECIMALS: .005
THIRD ANGLE PROJECTION

4 | OPTIONAL | THERMAL PAD 1.57X1.57" OR FULL COVERAGE | 1
5 | 4C87PPMZB | 4-40 X 7/8" PHIL PAN MS BLACK ROHS | 4

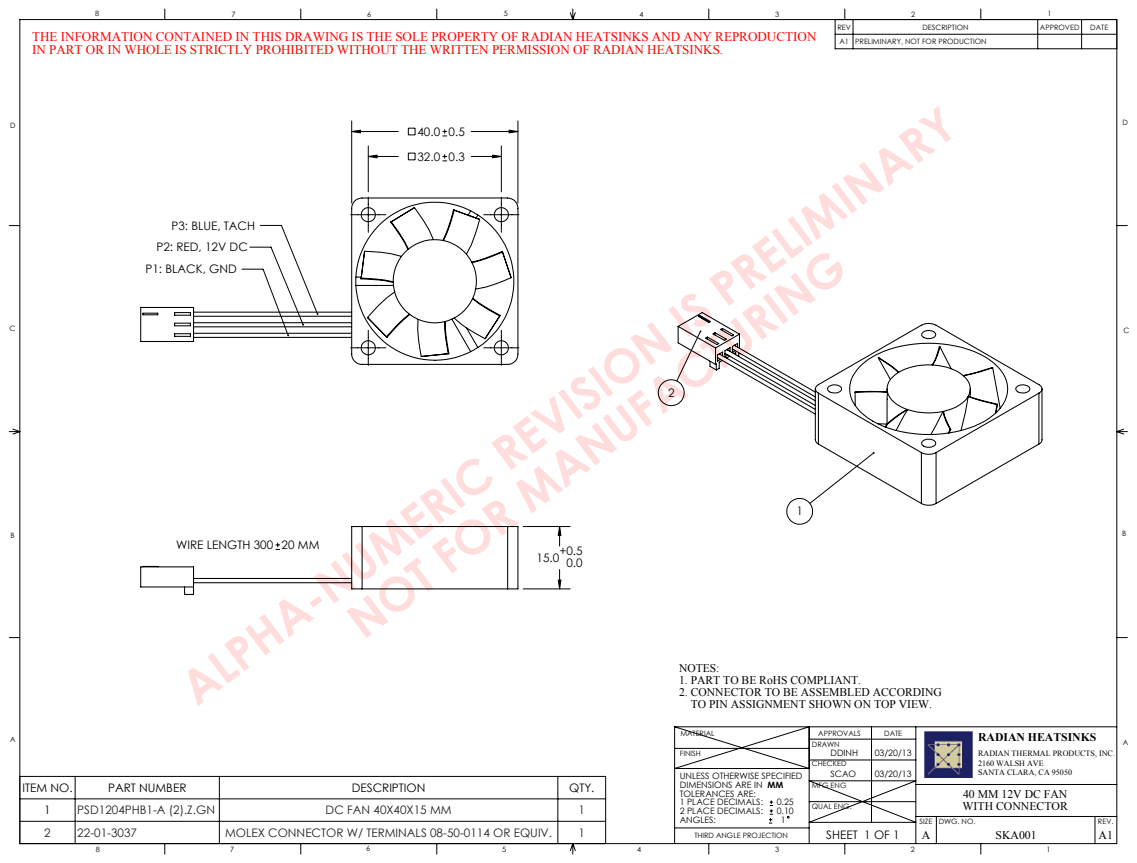
[picture p89: page 2]
P3: BLUE, TACH P2: RED, 12V DC P1: BLACK, GND; SIZE DWG. NO.; REV.; SHEET 1 OF 1; MFG ENG; QUAL ENG.

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

REV | DESCRIPTION | APPROVED | DATE
A1 | PRELIMINARY, NOT FOR PRODUCTION

ALPHA-NUMERIC REVISION IS PRELIMINARY

NOT FOR MANUFACTURING

WIRE LENGTH 300 20 MM

NOTES:
1. PART TO BE RoHS COMPLIANT.
2. CONNECTOR TO BE ASSEMBLED ACCORDING
TO PIN ASSIGNMENT SHOWN ON TOP VIEW.

RADIAN HEATSINKS
RADIAN THERMAL PRODUCTS, INC.
2160 WALSH AVE
SANTA CLARA, CA 95050
40 MM 12V DC FAN
WITH CONNECTOR

FINISH
UNLESS OTHERWISE SPECIFIED
DIMENSIONS ARE IN MM
TOLERANCES ARE:
1 PLACE DECIMALS: 0.25
2 PLACE DECIMALS: 0.10
THIRD ANGLE PROJECTION

ITEM NO. | PART NUMBER | DESCRIPTION | QTY.
1 | PSD1204PHB1-A (2).Z.GN | DC FAN 40X40X15 MM | 1
2 | 22-01-3037 | MOLEX CONNECTOR W/ TERMINALS 08-50-0114 OR EQUIV. | 1
