ska-sa/roach2_chassis_design/Pro-Engineer_Files/ROACH_2_Chassis/roach_2_hardware.pdf

1 | 2 | 3 | 4 | 5

A

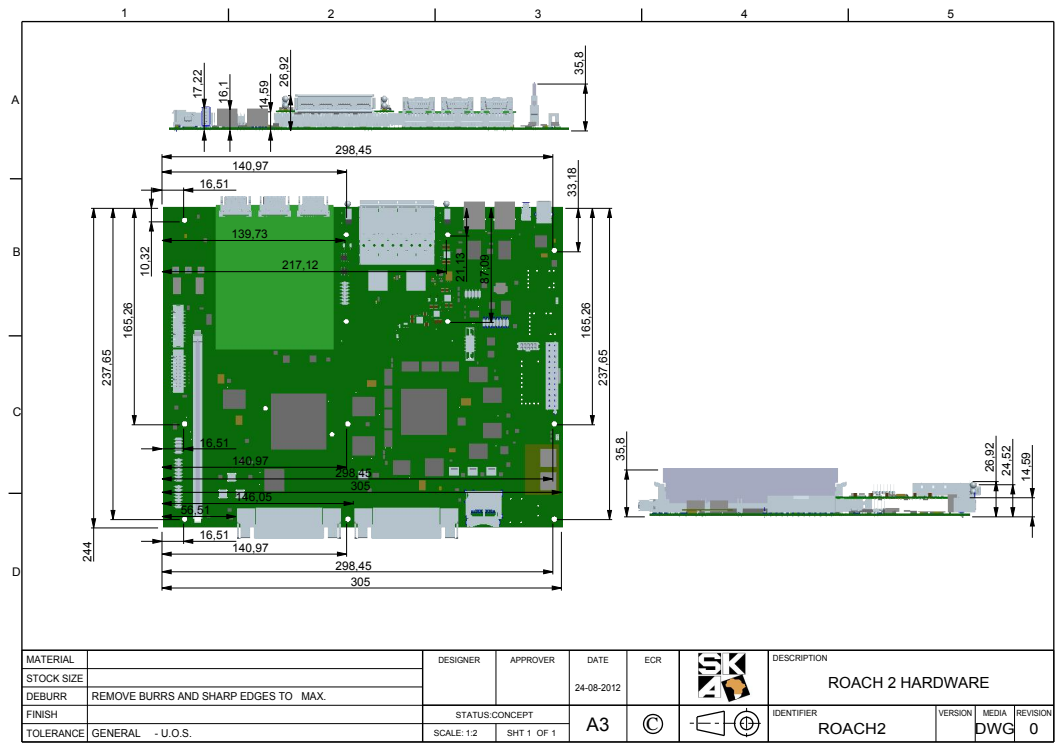
[picture p90: page 1]
TOLERANCE; GENERAL - U.O.S.; SCALE: 1:2; SHT 1 OF 1; ROACH2; DWG; ROACH 2 HARDWARE STOCK SIZE; MATERIAL; DESIGNER; APPROVER; DATE; ECR; DESCRIPTION

DEBURR | REMOVE BURRS AND SHARP EDGES TO MAX.
FINISH | | STATUS: CONCEPT | C | IDENTIFIER | VERSION | MEDIA | REVISION
