ska-sa/roach2_chassis_design/Pro-Engineer_Files/ROACH_2_Chassis_SMA/macro_dimensions.pdf

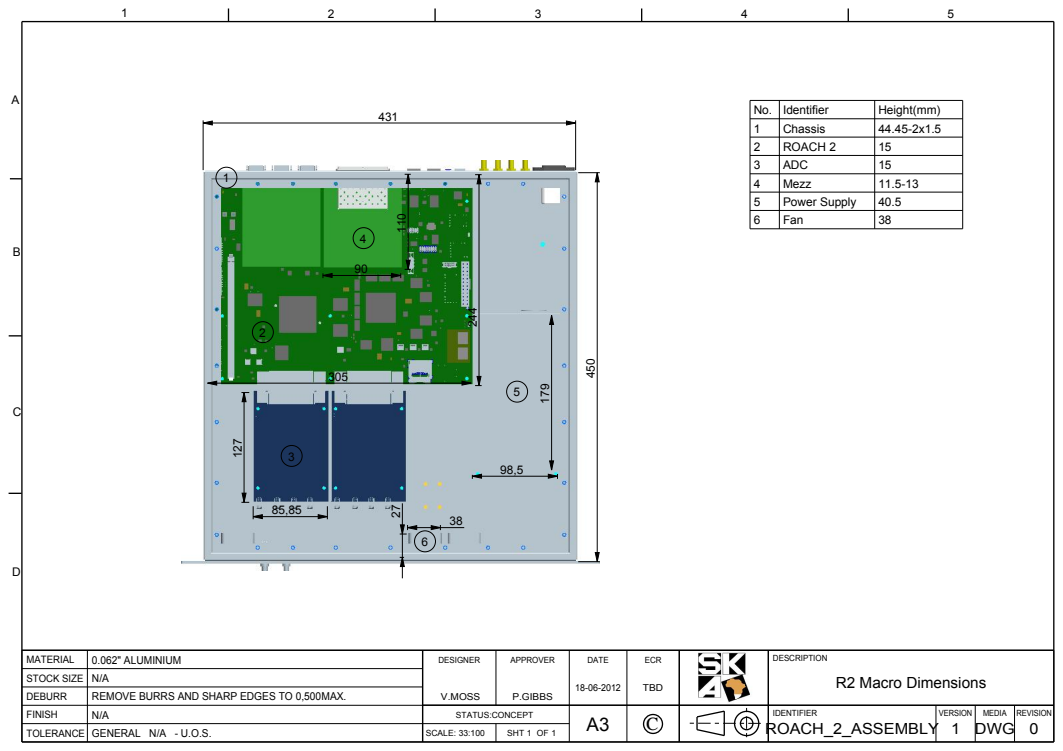
[picture p91: page 1]
TOLERANCE; GENERAL N/A - U.O.S.; SCALE: 33:100; SHT 1 OF 1; ROACH_2_ASSEMBLY 1; DWG

No. | Identifier | Height(mm)
1 | Chassis | 44.45-2x1.5
2 | ROACH 2 | 15
3 | ADC | 15
4 | Mezz | 11.5-13
5 | Power Supply | 40.5
6 | Fan | 38

MATERIAL | 0.062" ALUMINIUM | DESIGNER V.MOSS | APPROVER P.GIBBS | DATE 18-06-2012 | ECR TBD | DESCRIPTION R2 Macro Dimensions STOCK SIZE
N/A
DEBURR | REMOVE BURRS AND SHARP EDGES TO 0,500 MAX.
FINISH | N/A | STATUS: CONCEPT | | C | | | IDENTIFIER | VERSION | MEDIA | REVISION
