ska-sa/roach2_chassis_design/Pro-Engineer_Files/ROACH_2_Chassis_SMA/ROACH-2-CHASSIS-INFO.pdf

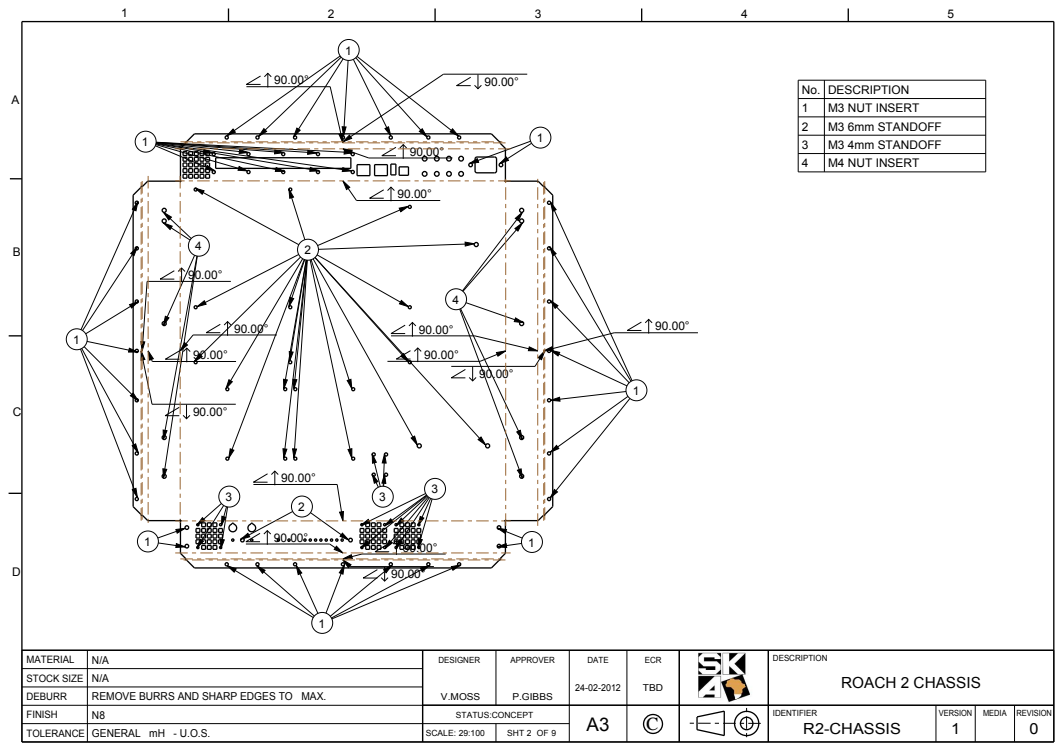
[picture p92: page 1]
TOLERANCE; GENERAL mH - U.O.S.; SCALE: 29:100; SHT 2 OF 9; R2-CHASSIS

No. | DESCRIPTION
1 | M3 NUT INSERT
2 | M3 6mm STANDOFF
3 | M3 4mm STANDOFF
4 | M4 NUT INSERT

MATERIAL | N/A | DESIGNER V.MOSS | APPROVER P.GIBBS | DATE 24-02-2012 | ECR TBD | DESCRIPTION ROACH 2 CHASSIS STOCK SIZE
N/A
DEBURR | REMOVE BURRS AND SHARP EDGES TO MAX.
FINISH | N8 | STATUS: CONCEPT | | C | | | IDENTIFIER | VERSION | MEDIA | REVISION
