ska-sa/roach2_chassis_design/Pro-Engineer_Files/ROACH_2_Chassis_SMA/ROACH-2-FRONT-PANEL.pdf

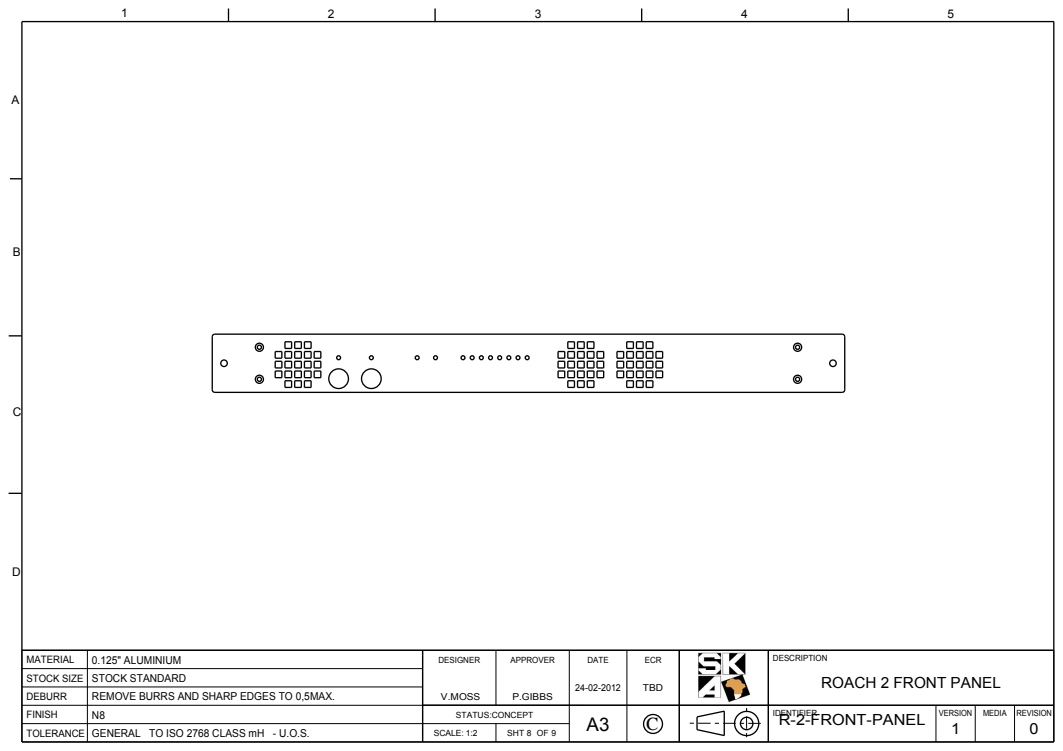
[picture p93: page 1]
C TOLERANCE; GENERAL TO ISO 2768 CLASS mH - U.O.S.; SCALE: 1:2; SHT 8 OF 9; R-2-FRONT-PANEL

MATERIAL | 0.125" ALUMINIUM | DESIGNER V.MOSS | APPROVER P.GIBBS | DATE 24-02-2012 | ECR TBD | DESCRIPTION ROACH 2 FRONT PANEL STOCK SIZE
STOCK STANDARD
DEBURR | REMOVE BURRS AND SHARP EDGES TO 0,5 MAX.
FINISH | N8 | STATUS: CONCEPT | | | | | IDENTIFIER | VERSION | MEDIA | REVISION
