ska-sa/roach2_chassis_design/Pro-Engineer_Files/ROACH_2_Chassis_SMA/ROACH-2-GENERAL.pdf

1 | 2 | 3 | 4 | 5

A

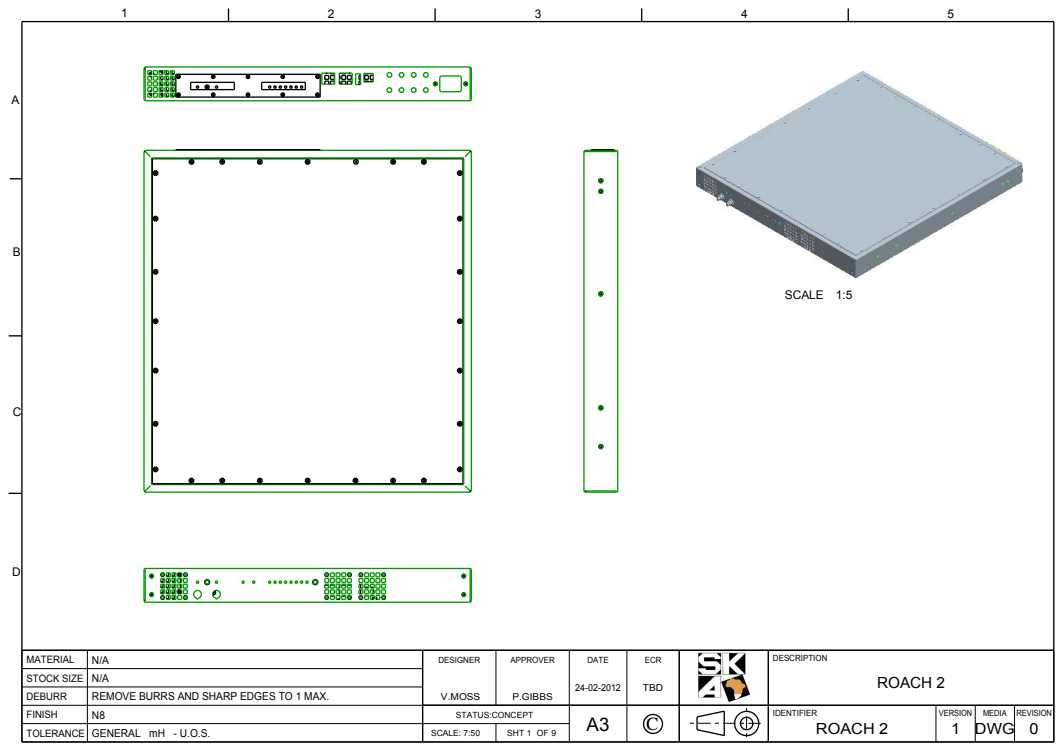
[picture p94: page 1]
C TOLERANCE; GENERAL mH - U.O.S.; SCALE: 7:50; SHT 1 OF 9; ROACH 2; DWG; SCALE 1:5

MATERIAL | N/A | DESIGNER V.MOSS | APPROVER P.GIBBS | DATE 24-02-2012 | ECR TBD | DESCRIPTION ROACH 2 STOCK SIZE
N/A
DEBURR | REMOVE BURRS AND SHARP EDGES TO 1 MAX.
FINISH | N8 | STATUS: CONCEPT | | | | | IDENTIFIER | VERSION | MEDIA | REVISION
