ska-sa/roach2_chassis_design/Pro-Engineer_Files/ROACH_2_Chassis_SMA/critical_dimensions.pdf

1 | 2 | 3 | 4 | 5

A

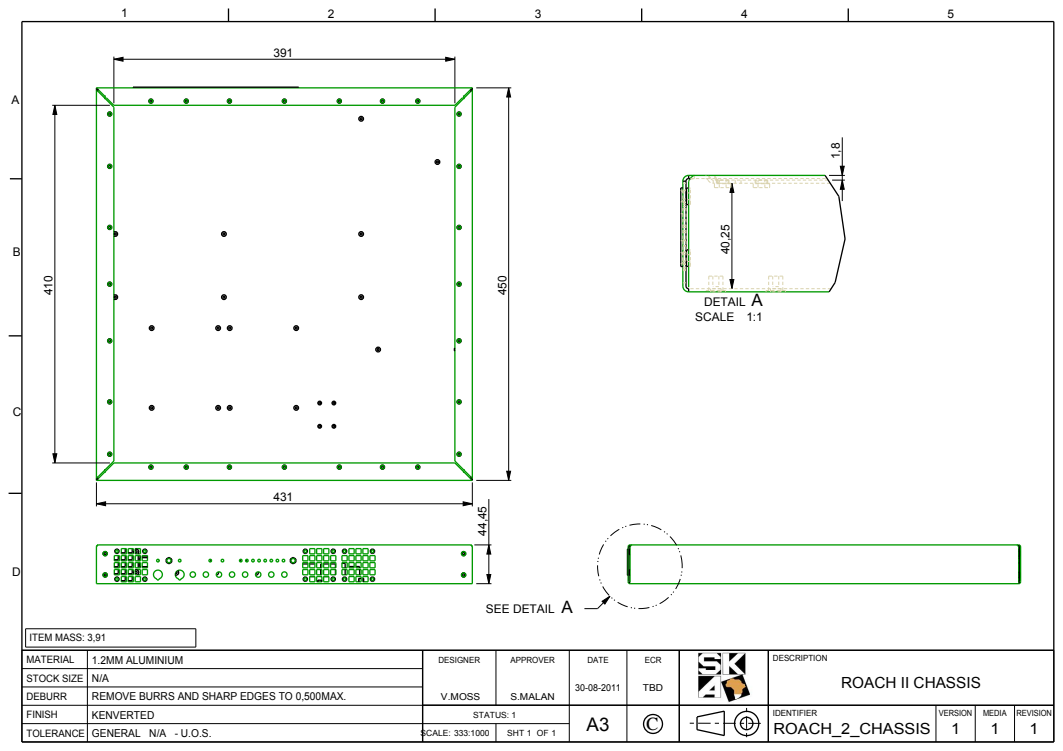
[picture p95: page 1]
TOLERANCE; GENERAL N/A - U.O.S.; SCALE: 333:1000; SHT 1 OF 1; ROACH_2_CHASSIS; ITEM MASS: 3,91; SEE DETAIL A; SCALE 1:1; DETAIL A

MATERIAL | 1.2MM ALUMINIUM | DESIGNER V.MOSS | APPROVER S.MALAN | DATE 30-08-2011 | ECR TBD | DESCRIPTION ROACH II CHASSIS STOCK SIZE
N/A
DEBURR | REMOVE BURRS AND SHARP EDGES TO 0,500 MAX.
FINISH | KENVERTED | STATUS: 1 | | C | | | IDENTIFIER | VERSION | MEDIA | REVISION
