ska-sa/roach2_chassis_design/Pro-Engineer_Files/ROACH_2_Chassis_SMA/front_face.pdf

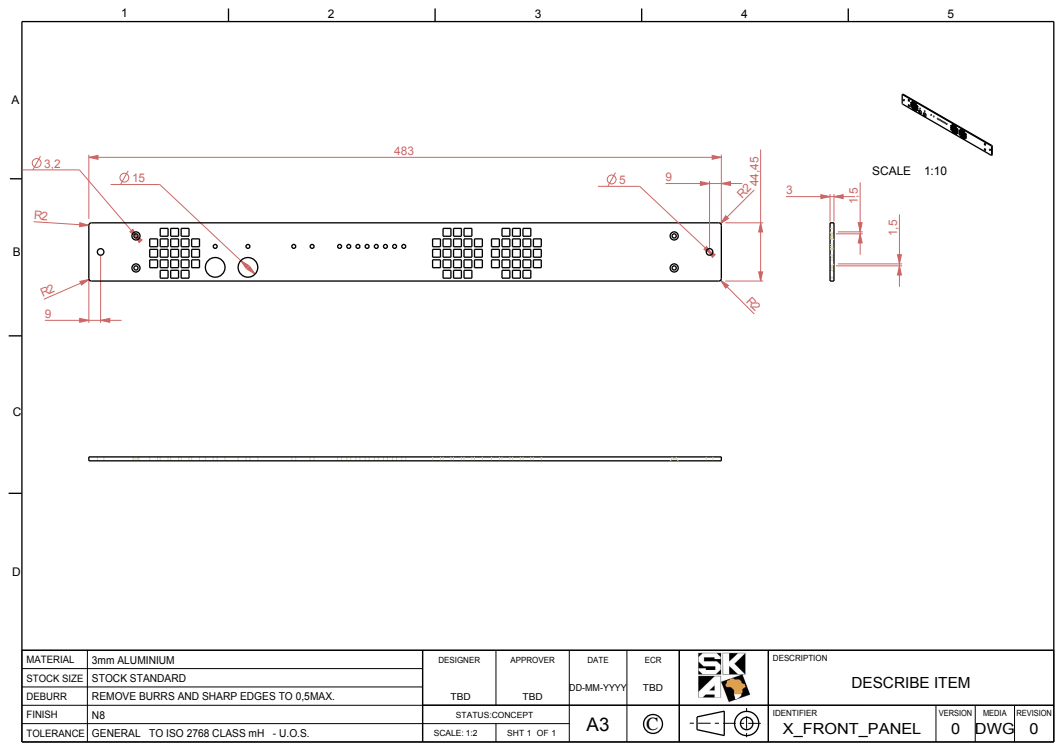
[picture p96: page 1]
TOLERANCE; GENERAL TO ISO 2768 CLASS mH - U.O.S.; SCALE: 1:2; SHT 1 OF 1; X_FRONT_PANEL; DWG; SCALE 1:10

MATERIAL | 3mm ALUMINIUM | DESIGNER TBD | APPROVER TBD | DATE DD-MM-YYYY | ECR TBD | DESCRIPTION DESCRIBE ITEM STOCK SIZE
STOCK STANDARD
DEBURR | REMOVE BURRS AND SHARP EDGES TO 0,5 MAX.
FINISH | N8 | STATUS: CONCEPT | | C | | | IDENTIFIER | VERSION | MEDIA | REVISION
