ska-sa/roach2_chassis_design/Pro-Engineer_Files/ROACH_2_Chassis_SMA/roach_2_back_panel.pdf

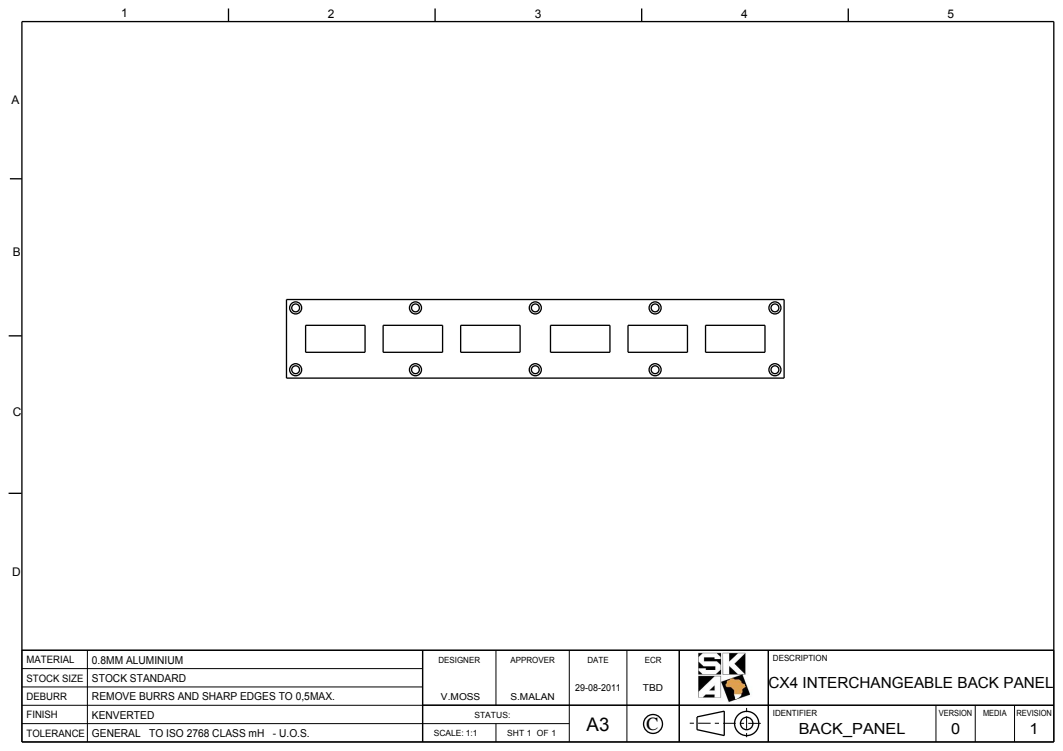
[picture p97: page 1]
C TOLERANCE; GENERAL TO ISO 2768 CLASS mH - U.O.S.; SCALE: 1:1; SHT 1 OF 1; BACK_PANEL

MATERIAL | 0.8MM ALUMINIUM | DESIGNER V.MOSS | APPROVER S.MALAN | DATE 29-08-2011 | ECR TBD | DESCRIPTION CX4 INTERCHANGEABLE BACK PANEL STOCK SIZE
STOCK STANDARD
DEBURR | REMOVE BURRS AND SHARP EDGES TO 0,5 MAX.
FINISH | KENVERTED | STATUS: | | | | | IDENTIFIER | VERSION | MEDIA | REVISION
