ska-sa/roach2_chassis_design/Pro-Engineer_Files/ROACH_2_Chassis_SMA/roach_2_chassis.pdf

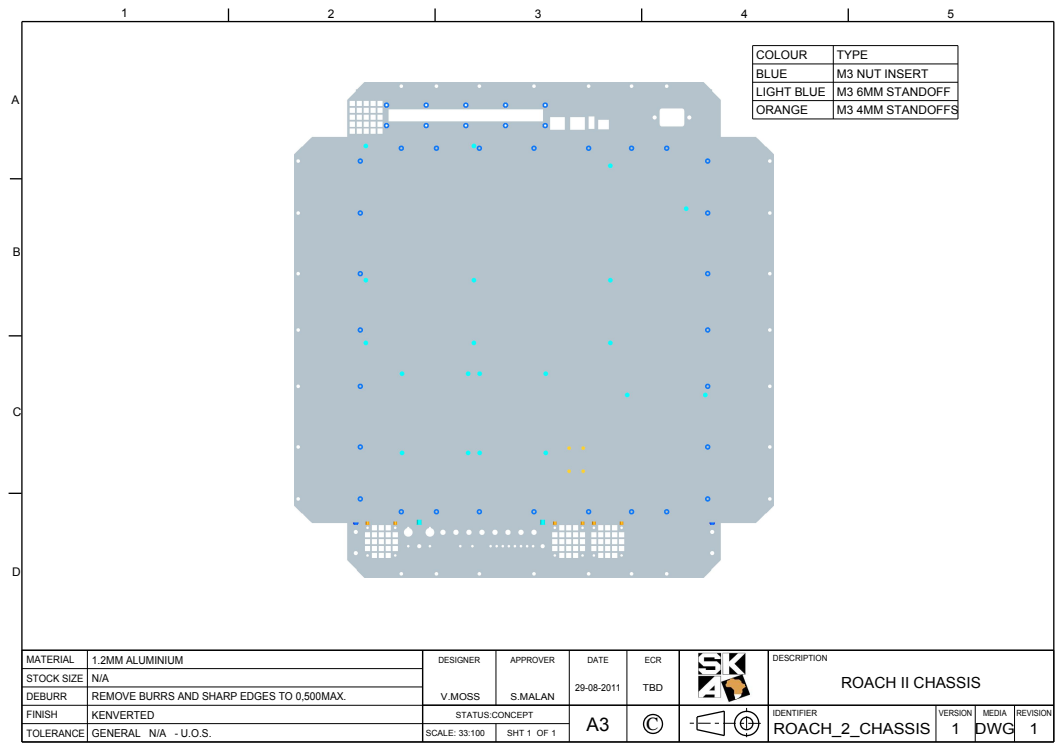
[picture p98: page 1]
C TOLERANCE; GENERAL N/A - U.O.S.; SCALE: 33:100; SHT 1 OF 1; ROACH_2_CHASSIS; DWG

COLOUR | TYPE
BLUE | M3 NUT INSERT
LIGHT BLUE | M3 6MM STANDOFF
ORANGE | M3 4MM STANDOFFS

MATERIAL | 1.2MM ALUMINIUM | DESIGNER V.MOSS | APPROVER S.MALAN | DATE 29-08-2011 | ECR TBD | DESCRIPTION ROACH II CHASSIS STOCK SIZE
N/A
DEBURR | REMOVE BURRS AND SHARP EDGES TO 0,500 MAX.
FINISH | KENVERTED | STATUS: CONCEPT | | | | | IDENTIFIER | VERSION | MEDIA | REVISION
