ska-sa/roach2_chassis_design/Pro-Engineer_Files/ROACH_2_Chassis_SMA/roach_2_lid.pdf

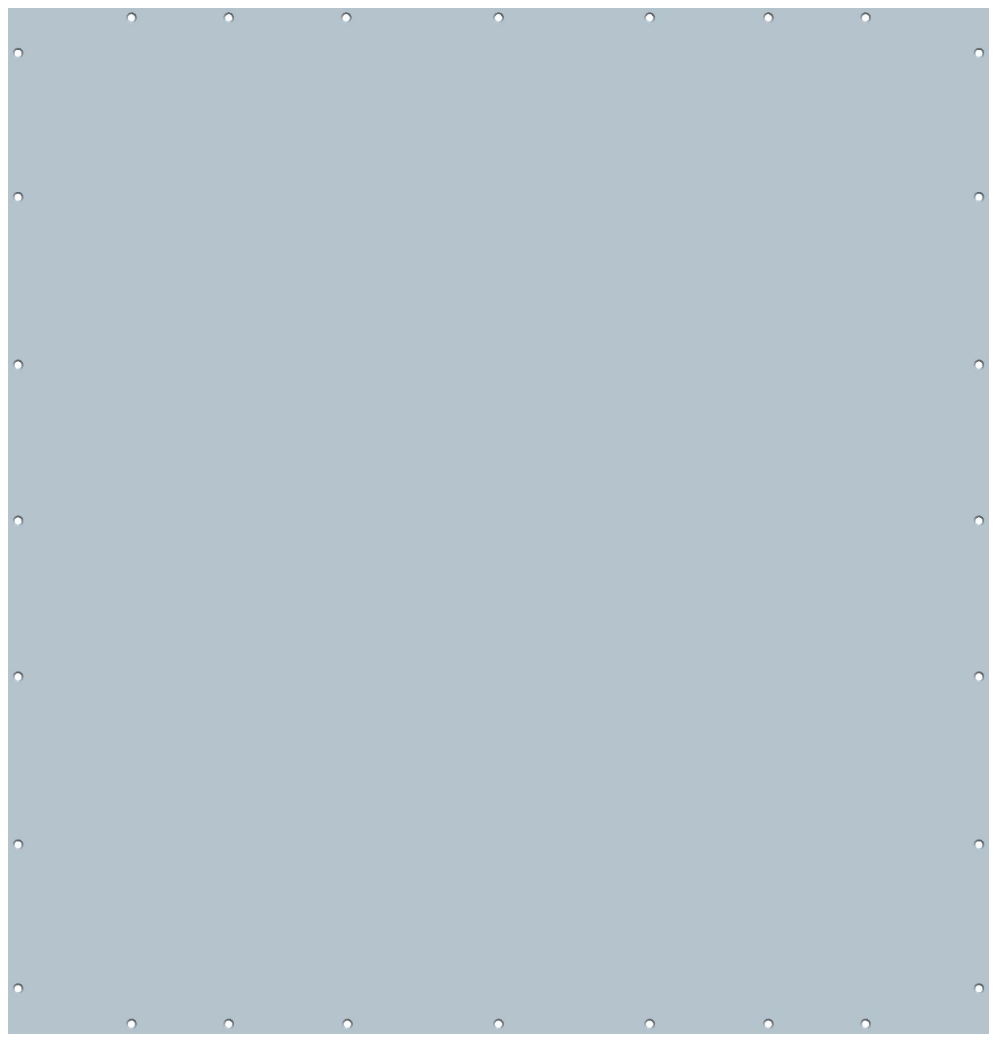
[picture p99: page 1]
C TOLERANCE; GENERAL TO ISO 2768 CLASS mH - U.O.S.; SCALE: 0.333; SHT 1 OF 1; ROACH_2_LID

MATERIAL | 0.8MM ALUMINIUM | DESIGNER V.MOSS | APPROVER S.MALAN | DATE 29-08-2011 | ECR TBD | DESCRIPTION ROACH II LID STOCK SIZE
STOCK STANDARD
DEBURR | REMOVE BURRS AND SHARP EDGES TO 0,5 MAX.
FINISH | KENVERTED | STATUS: | | | | | IDENTIFIER | VERSION | MEDIA | REVISION
