ska-sa/roach2_chassis_design/Pro-Engineer_Files/ROACH_2_Chassis_SMA/roach_iso.pdf

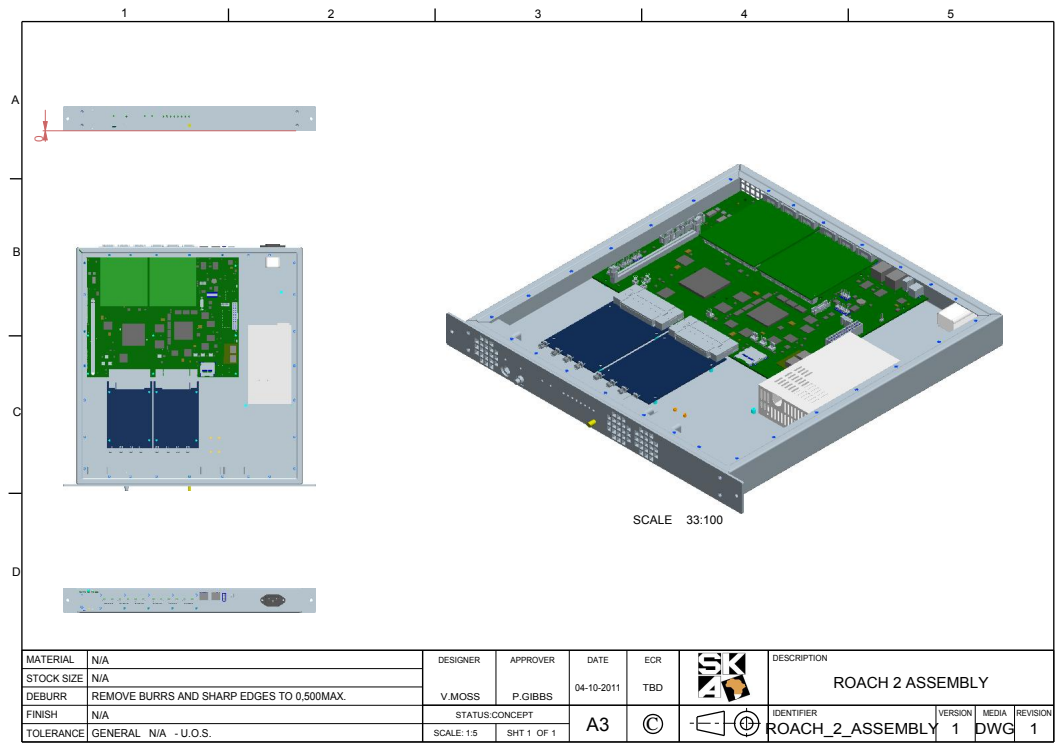
[picture p100: page 1]
TOLERANCE; GENERAL N/A - U.O.S.; SCALE: 1:5; SHT 1 OF 1; ROACH_2_ASSEMBLY 1; DWG; SCALE 33:100

MATERIAL | N/A | DESIGNER V.MOSS | APPROVER P.GIBBS | DATE 04-10-2011 | ECR TBD | DESCRIPTION ROACH 2 ASSEMBLY STOCK SIZE
N/A
DEBURR | REMOVE BURRS AND SHARP EDGES TO 0,500 MAX.
FINISH | N/A | STATUS: CONCEPT | | C | | | IDENTIFIER | VERSION | MEDIA | REVISION
