ska-sa/roach2_chassis_design/roach_2_manufacture/documentation/roach-2-chassis-front-panel.pdf

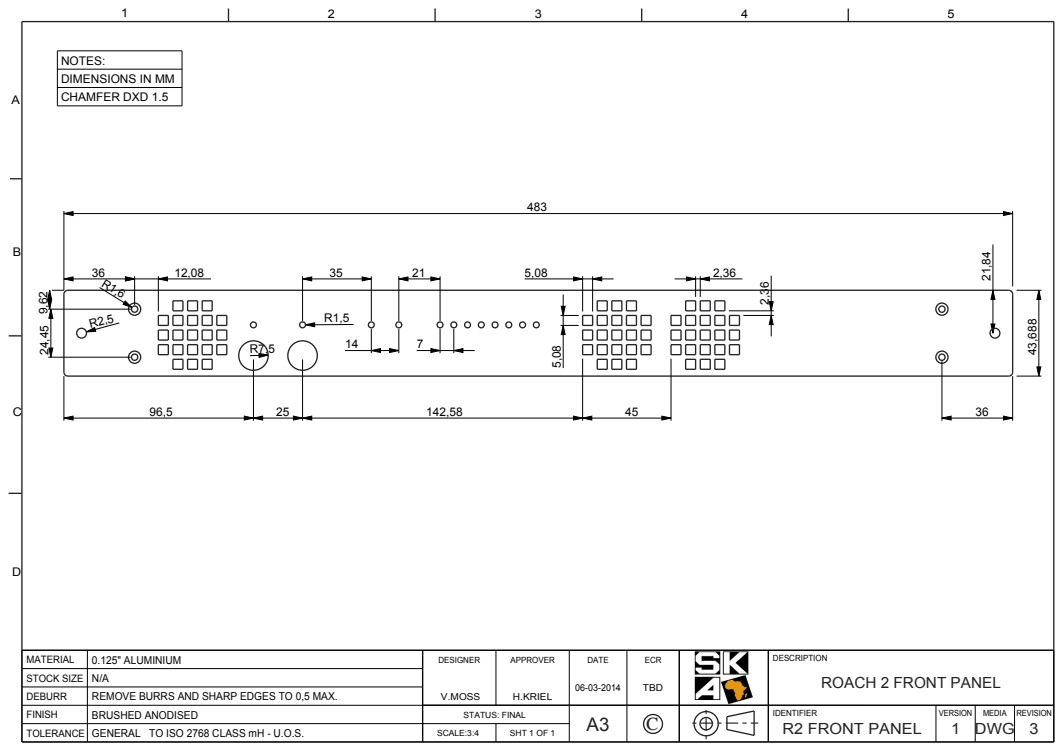
[picture p101: page 1]
TOLERANCE; GENERAL TO ISO 2768 CLASS mH - U.O.S.; SCALE:3:4; SHT 1 OF 1; R2 FRONT PANEL; DWG

NOTES:
DIMENSIONS IN MM
CHAMFER DXD 1.5

MATERIAL | 0.125" ALUMINIUM | DESIGNER V.MOSS | APPROVER H.KRIEL | DATE 06-03-2014 | ECR TBD | DESCRIPTION ROACH 2 FRONT PANEL STOCK SIZE
N/A
DEBURR | REMOVE BURRS AND SHARP EDGES TO 0,5 MAX.
FINISH | BRUSHED ANODISED | STATUS: FINAL | | C | | | IDENTIFIER | VERSION | MEDIA | REVISION
