ska-sa/roach2_chassis_design/roach_2_manufacture/documentation/roach-2-chassis-lid.pdf

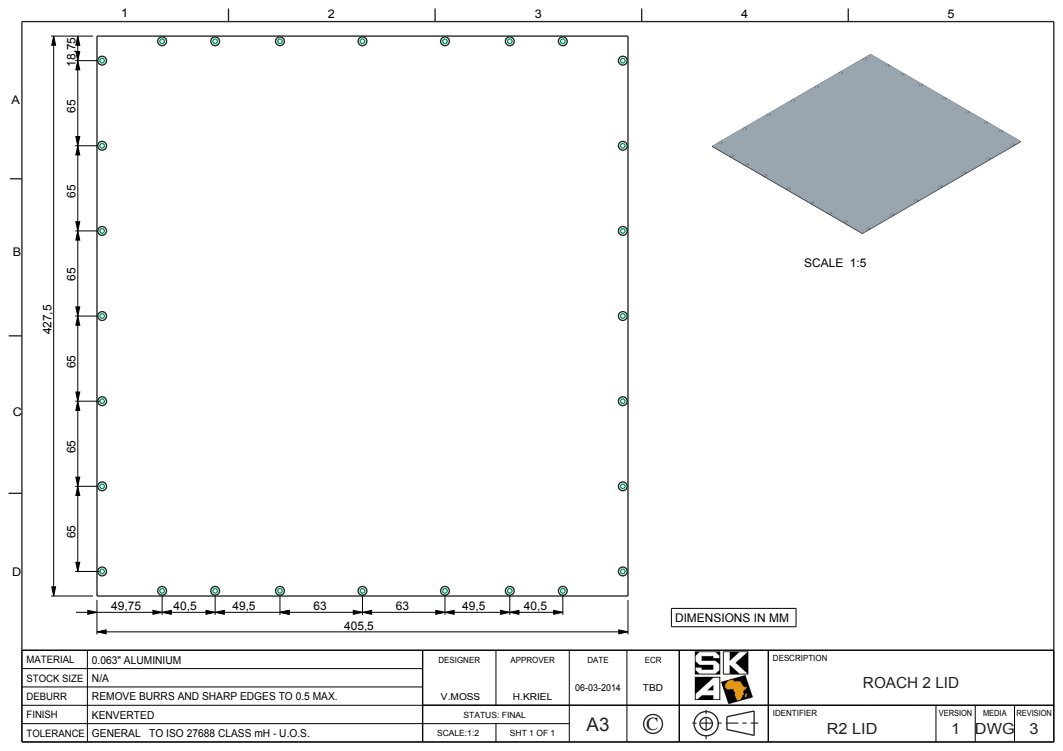
[picture p102: page 1]
TOLERANCE; GENERAL TO ISO 27688 CLASS mH - U.O.S.; SCALE:1:2; SHT 1 OF 1; R2 LID; DWG; SCALE 1:5

DIMENSIONS IN MM

MATERIAL | 0.063" ALUMINIUM | DESIGNER V.MOSS | APPROVER H.KRIEL | DATE 06-03-2014 | ECR TBD | DESCRIPTION ROACH 2 LID STOCK SIZE
N/A
DEBURR | REMOVE BURRS AND SHARP EDGES TO 0.5 MAX.
FINISH | KENVERTED | STATUS: FINAL | | C | | | IDENTIFIER | VERSION | MEDIA | REVISION
