ska-sa/roach2_chassis_design/roach_2_manufacture/silkscreens/back_panels.pdf

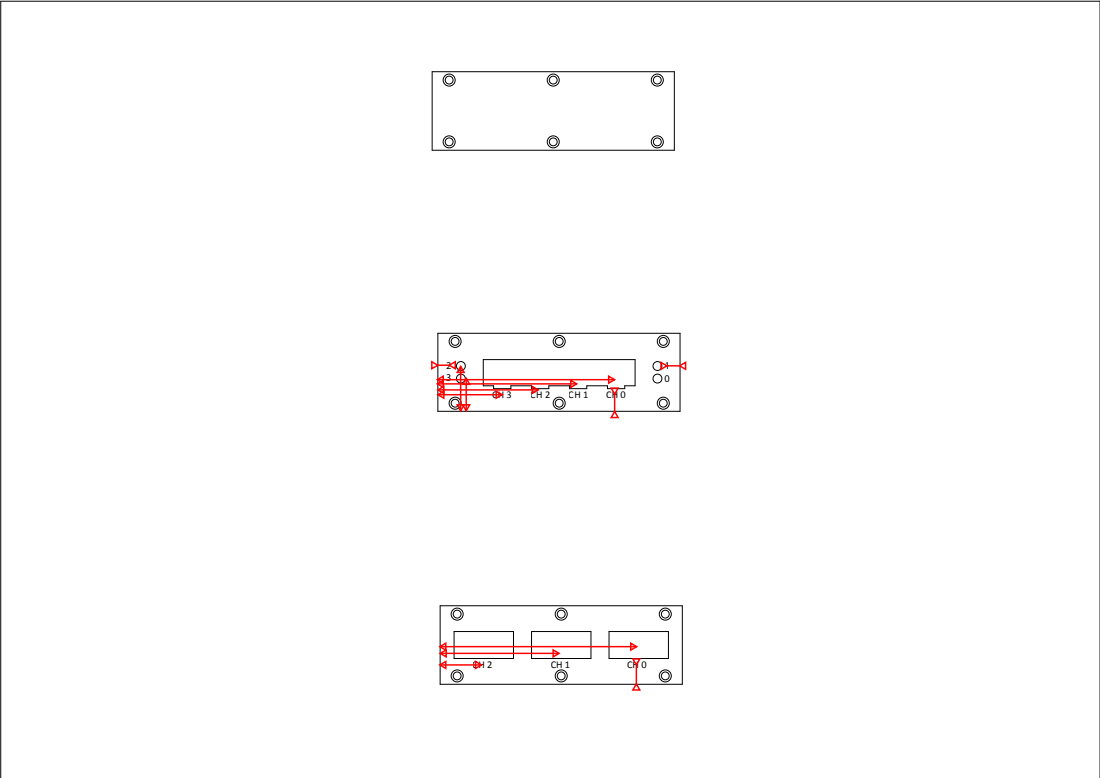
[picture p103: page 1]
