ska-sa/roach2_chassis_design/Pro-Engineer_Files/ROACH_2_Chassis_SMA/ROACH-2-BACK-PANELS.pdf

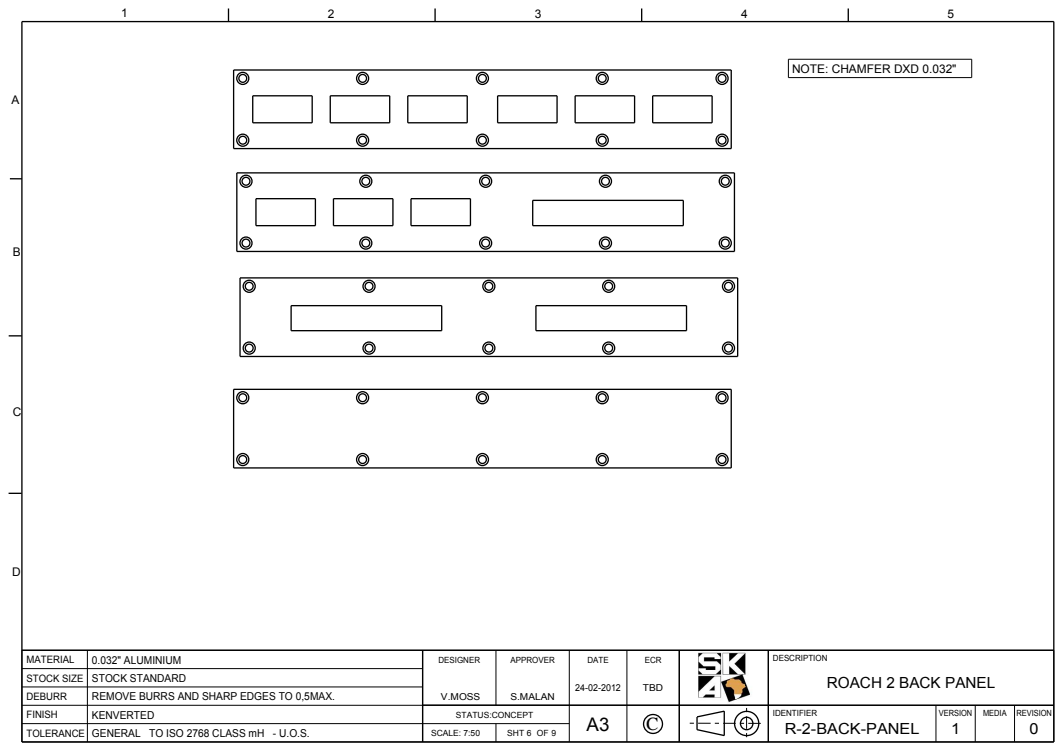
[picture p104: page 1]
C TOLERANCE; GENERAL TO ISO 2768 CLASS mH - U.O.S.; SCALE: 7:50; SHT 6 OF 9; R-2-BACK-PANEL

NOTE: CHAMFER DXD 0.032"

MATERIAL | 0.032" ALUMINIUM | DESIGNER V.MOSS | APPROVER S.MALAN | DATE 24-02-2012 | ECR TBD | DESCRIPTION ROACH 2 BACK PANEL STOCK SIZE
STOCK STANDARD
DEBURR | REMOVE BURRS AND SHARP EDGES TO 0,5 MAX.
FINISH | KENVERTED | STATUS: CONCEPT | | | | | IDENTIFIER | VERSION | MEDIA | REVISION
