ska-sa/roach2_chassis_design/Pro-Engineer_Files/ROACH_2_Chassis_SMA/ROACH-2-LID.pdf

1 | 2 | 3 | 4 | 5

A

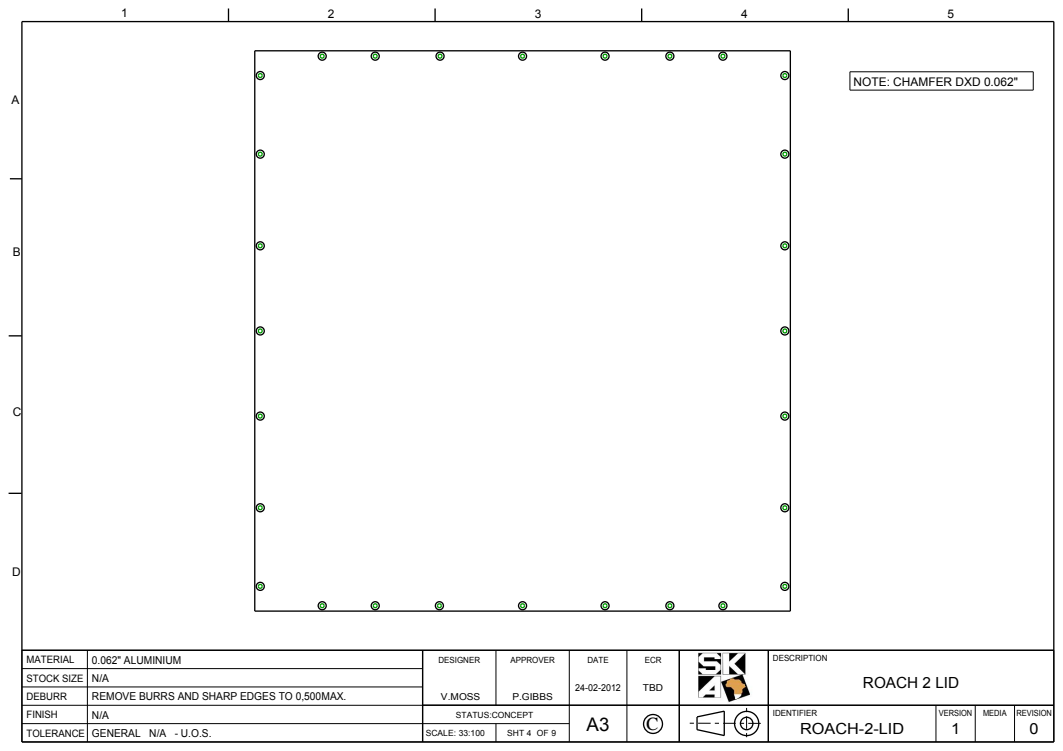
[picture p105: page 1]
C TOLERANCE; GENERAL N/A - U.O.S.; SCALE: 33:100; SHT 4 OF 9; ROACH-2-LID

NOTE: CHAMFER DXD 0.062"

MATERIAL | 0.062" ALUMINIUM | DESIGNER V.MOSS | APPROVER P.GIBBS | DATE 24-02-2012 | ECR TBD | DESCRIPTION ROACH 2 LID STOCK SIZE
N/A
DEBURR | REMOVE BURRS AND SHARP EDGES TO 0,500 MAX.
FINISH | N/A | STATUS: CONCEPT | | | | | IDENTIFIER | VERSION | MEDIA | REVISION
