ska-sa/roach2_chassis_design/(commit log)

2012-05-10 Removing obsolete files
    [roach_2_chassis_asm.stp, roach_2_chassis_asm_1.stp, roach_2_chassis_sheet_rev_2.stp, roach_2_chassis_sheet_rev_2_flattened.stp, x_front_panel.igs, x_front_panel.stp]
2012-05-10 adding latest roach 2 design
    [ROACH-2-LID.dxf, back_panel_blank.stp, back_panel_cx4.stp, back_panel_mix.stp, back_panel_sfp.stp, front_panel.stp, roach-2-back-panels.dxf, roach-2-chassis.dxf]
2012-06-06 ROACH 2 Thermal Analaysis Updates and AllFab Documentation
    [ROACH-2-LID.dxf, roach-2-back-panels.dxf, roach-2-chassis.dxf, roach-2-front-panel.dxf]
2012-06-15 ROACH 2 Chassis SMA hole from 6.2 to 6.4, clean up back panel hole, add silkscreens
2012-06-15 ROACH 2 Back Plates Update
2012-06-18 ROACH 2 rename to rev 6
    [ROACH-2-LID.dxf, back_panel_blank.stp, back_panel_cx4.stp, back_panel_mix.stp, back_panel_sfp.stp, front_panel.stp, roach-2-back-panels.dxf, roach-2-chassis.dxf]
2012-06-26 roach 2 manufacture added
    [back_panel_blank.stp, back_panel_cx4.stp, back_panel_sfp.stp, roach-2-chassis-back-panels.dxf, roach-2-chassis-flat-dxf.dxf, roach-2-chassis-front-panel.dxf, roach-2-chassis-lid.dxf, roach-2-chassis-manufacturer_bck.dxf]
2012-06-28 R2 front panel variation added
    [ROACH-2-LID.dxf, back_panel_blank.stp, back_panel_cx4.stp, back_panel_mix.stp, back_panel_sfp.stp, front_panel.stp, front_panel_front_holes.stp, roach-2-back-panels.dxf]
2012-07-04 chassis made 3mm narrower to accomodate istar rails
    [roach-2-chassis-back.dxf, roach-2-chassis-flat-dxf.dxf, roach-2-chassis-lid.dxf, roach_2_chassis.stp, roach_2_lid.stp]
2012-07-12 update rev 6 + update manufacturer files
    [front_panel.stp, front_panel_j.stp, roach-2-chassis-back-panels.dxf, roach-2-chassis-back.dxf, roach-2-chassis-front-panel.dxf, roach_2_chassis_sheet_j.stp]
2012-08-24 updates of manufacturing and new katadc
    [front_panel.dxf]
2012-08-29 added ROACH 2 CAD
2012-08-30 rm ROACH 2 CAD/ r2 step file
2012-09-14 Minor changes to rev 6 and roach_2_cfd
    [User Library-ddr3 dimm sdram.STEP]
2012-12-04 update after many changes
    [ROACH-2-LID.dxf, User Library-ddr3 dimm sdram.STEP, back_panel_blank.stp, back_panel_cx4.stp, back_panel_mix.stp, back_panel_sfp.stp, front_panel.stp, roach-2-back-panels.dxf]
2013-02-20 CFD Model Updates
    [new_adc.stp]
2013-05-08 update of master, added bom to manufacture
2013-05-08 removed old roach 2 cad files
    [ROACH-2-LID.dxf, User Library-ddr3 dimm sdram.STEP, back_panel_blank.stp, back_panel_cx4.stp, back_panel_mix.stp, back_panel_sfp.stp, front_panel.stp, front_panel_front_holes.stp]
2013-05-08 Added the ROACH2 LED frontpanel PCB files
    These files were originally hosted in the roach2_hardware main repository.
    [K3000-0176_B.PcbDoc, K3000-0176_B.SchDoc, ROACH2_LED.PcbDoc, ROACH2_LED.PrjPCB, ROACH2_LED.SchDoc, ROACH2_LED_BOM.xlsx]
2013-05-08 Removed LED frontpanel PCB files
    These are now hosted in their own repository: https://github.com/jmanley/roach2_ledstatus_frontpanel_pcb
    [K3000-0176_B.PcbDoc, K3000-0176_B.SchDoc, ROACH2_LED.PcbDoc, ROACH2_LED.PrjPCB, ROACH2_LED.SchDoc, ROACH2_LED_BOM.xlsx]
2013-05-10 Added README, Renamed R2 Chassis File
    [ROACH-2-LID.dxf, User Library-ddr3 dimm sdram.STEP, back_panel_blank.stp, back_panel_cx4.stp, back_panel_mix.stp, back_panel_sfp.stp, front_panel.stp, roach-2-back-panels.dxf]
2013-05-10 Moved rp-rail-20-1u
    Moved the rp-rail-20-1u to the pro engineer folder
2013-05-10 renamed roach_2_chassis_front_holes
    renamed folder roach_2_chassis_front_holes to roach_2_chassis_SMA
    [ROACH-2-LID.dxf, back_panel_blank.stp, back_panel_cx4.stp, back_panel_mix.stp, back_panel_sfp.stp, front_panel.stp, roach-2-back-panels.dxf, roach-2-chassis-manufacturer_bck.dxf]
2013-05-10 moved roach_2_chassis
    moved above to pro-engineer folder
    [ROACH-2-LID.dxf, User Library-ddr3 dimm sdram.STEP, back_panel_blank.stp, back_panel_cx4.stp, back_panel_mix.stp, back_panel_sfp.stp, front_panel.stp, roach-2-back-panels.dxf]
2013-05-10 removed roach_2_chassis_SMA
    [ROACH-2-LID.dxf, back_panel_blank.stp, back_panel_cx4.stp, back_panel_mix.stp, back_panel_sfp.stp, front_panel.stp, roach-2-back-panels.dxf, roach-2-chassis-manufacturer_bck.dxf]
2013-05-10 added roach_2_sma to pro engineer folder
    [ROACH-2-LID.dxf, back_panel_blank.stp, back_panel_cx4.stp, back_panel_mix.stp, back_panel_sfp.stp, front_panel.stp, roach-2-back-panels.dxf, roach-2-chassis-manufacturer_bck.dxf]
2013-05-10 roach_2_manufature updated
    rev 2 bom file, supporting documentation and readme updated
2013-05-10 roach_2_manufacture bom updated
2013-05-23 update of maunafturing pack
    [back_panel_cx4.stp, back_panel_sfp.stp, front_panel.stp, roach-2-chassis-back-panels.dxf, roach-2-chassis-back.dxf, roach-2-chassis-flat-dxf.dxf, roach-2-chassis-front-panel.dxf, roach-2-chassis-lid.dxf]
2013-11-07 major revision
    height change to 39.7mm, psu change, extra mounting holes added for
    sfp/cx4 cards, removable back plates modified to largen openings, rail
    holes corrected.
    [front_panel.dxf, front_panel.stp, roach-2-chassis-back-panels.dxf, roach-2-chassis-back.dxf, roach-2-chassis-flat.dxf, roach-2-chassis-front-panel.dxf, roach-2-chassis-lid.dxf, roach-2-chassis.stp]
2013-11-07 correction on chassis stp and dxf files
    [roach-2-chassis-flat-dxf.dxf, roach-2-chassis-flat.dxf, roach-2-chassis.stp, roach_2_chassis.stp]
2013-11-07 back panels updated
    [back_panel_cx4.stp, back_panel_sfp.stp, roach-2-chassis-back-panels.dxf]
2013-11-07 custom bracket added
    [tc-1u20fx2_bracket.stp]
2013-11-07 bom updated and readme
2013-12-18 updated sfp back panel
    [back_panel_sfp.stp, roach-2-chassis-back-panels.dxf]
2014-04-12 Current ROACH 2 Chassis
    [keystone-PN615.STEP, roach-2-chassis-back.dxf]
2014-04-15 Added ROACH 2 Rev 2 PCB in stp format
2014-04-24 Updated manufacturing pack - SMA holes put back in
    [roach-2-chassis-flat.dxf, roach-2-chassis.stp]
2014-06-10 Added .stp file of cfd model
    [cfd-roach-2-assembly.stp]
